mchirlin/camping-escape-room/08-safety-and-compliance/NOTES.md

# Safety — Notes

Project: 2026-camping-minecraft
Created: 2026-04-18
Last updated: 2026-08-25

> **Source of truth:** the authoritative game flow is
> `../02-puzzle-design/flowchart.md`. If anything here disagrees with the
> flowchart, the flowchart wins.

## Assessment — All Clear

- **Stream:** Not deep — ankle-level. Safe for fishing step
- **Allergies:** None in the group
- **Supervision:** Other parents around and available
- **Bathroom/Mine:** Dedicated stall with own exterior door. Only group using the facilities
- **Sword:** Foam only — confirmed
- **TNT / props:** All foam or lightweight props — nothing that can hurt anyone

## Pre-Game Checklist
- [ ] Walk the route for trip hazards, sharp edges, poison ivy
- [ ] Check stream level day-of
- [ ] Confirm bathroom stall is clear and available
- [ ] Test creeper stability — shouldn't fall on a kid, only fall apart when hit
- [ ] Have water/sunscreen available (summer outdoor game)

## No Concerns
- No fog, strobes, or scent effects
- Daytime game — no darkness/visibility issues
- All parents present
- No food allergies to worry about for treats
