mchirlin/camping-escape-room/10-playtesting-and-iteration/NOTES.md

# Playtesting — Notes

Project: 2026-camping-minecraft
Created: 2026-04-18
Last updated: 2026-08-25

> **Source of truth:** the authoritative game flow is
> `../02-puzzle-design/flowchart.md`. If anything here disagrees with the
> flowchart, the flowchart wins.

## Decisions

### Home Testing
- Test crafting table at home — RFID reads, recipe recognition, sound effects, button
- Test all block tags individually and in grid combinations
- Test read range through table surface material

### Playtest Person
- Wife will do a full walkthrough pretending to be a player
- Can't use daughter — would spoil the game

### Campsite Dry Run
- Arrive early on game day
- Hide all blocks, walk the full route
- Test fishing magnet in the actual stream
- Verify creeper placement (stable but falls apart when hit)
- Confirm the locked chest opens cleanly on cue

### Backup Plans (stay flexible)
- RFID reader dies → game master manually confirms recipes (kids place blocks, you check visually, play sound from phone)
- Blocks go missing → have a few spare blocks of each type
- Stream too high → hide the diamonds near the stream bank instead of in the water
- Creeper won't stay up → lean it against a tree
- Weather → crafting table is in tent (covered), outdoor steps still work in light rain

## Pre-Trip Test Checklist
- [ ] Every block tag reads correctly on every grid slot
- [ ] All 10 recipes recognized
- [ ] Wrong recipes correctly rejected
- [ ] Sound plays on success
- [ ] Button works reliably
- [ ] Power bank lasts 2+ hours (enough for two runs)
- [ ] Fishing magnet holds the container
- [ ] Creeper falls apart and re-stacks easily
