mchirlin/camping-escape-room/09-budget-and-timeline/NOTES.md

# Budget & Timeline — Notes

Project: 2026-camping-minecraft
Created: 2026-04-18

## Budget: ~$200

### Breakdown
| Category | Estimate | Notes |
|---|---|---|
| Electronics (PN532 readers, ESP32, multiplexer, NeoPixel rings, speaker, NFC tags, copper tape, wiring) | $120 | Splurge item |
| 3D printing filament | $30 | Blocks + dragon egg |
| Spray paint | $15 | Multiple colors for block types |
| Crafting table wood/materials | $30 | Splurge item |
| Candy/treats | $20 | Finale chest + bonus recipes |
| Cardboard boxes + paint (creeper) | $10 | |
| Misc (magnets, string, parchment) | $15 | |
| **Total** | **~$250** | A bit over $200 — trim misc/treats if needed |

### Already Owned
- 3D printer
- ESP32 or ESP8266
- Maybe an RC522
- Kid-sized garden shovel
- Chests, keys, diary, locks
- Minecraft fox stuffed animal

### Splurge Priority
- Crafting table + blocks — the centerpiece of the whole game

## Timeline: July or August

### Milestones
| When | What |
|---|---|
| May | Order electronics, start 3D printing blocks, design crafting table |
| June | Build crafting table, write Arduino code, test RFID reads at home |
| Early July | Build creeper, make recipe scrolls, paint shovel, prep map |
| Week before trip | Wife playtest, pack everything, prep dig container |
| Day of | Arrive early, hide blocks, set up table in tent, bury chest, go |

### Build Time
- A few hours per week + a few full weekends
- Spread over ~3 months — very doable
