mchirlin/camping-escape-room/05-technology-and-electronics/crafting-table-firmware/dev-preview.html

# ⬜ Crafting Table

Escape Room Control Panel

DEV PREVIEW — mock backend, no hardware connected

Game

Admin

Test

## Slot Status

Touch1: -Touch2: -

## Recipes

Each recipe shows its state. Lock/Unlock to control whether the table will craft it; Craft force-fires it (door + sound + lights) if a piece is lost.

🔄 Reset Game (unlock all)

## Register Tags

Place tag on slot 4 (center), select type, tap Program.

Current: —

💾 Program

## Music

30

## Status

DFPlayer: -

## Log

Connecting...

## LED Tests

💡 Light Test🐛 Pixel Crawl⚫ All Off

## Door Lights

🚪 Door 0🚪 Door 1🚪 Door 2

⚫ Door Lights Off

## Motors

Servo 0Servo 1Servo 2

📳 Vibe ONVibe OFF

0

## Simulate Slots

Tap to toggle LEDs:
