mchirlin/camping-escape-room/04-props-and-materials/sticker-paper.pdf

## paper — Item Stickers (cut along outline)

paper — 1 pixel = 0.2000" — print at 100% on vinyl sticker paper
