mchirlin/camping-escape-room/01-theme-and-narrative/victory-song.md

# Victory Song — "Craft Your Way Home"

Plays at the very end of the event, right after the players blow open the
treasure chest and find the Ender Dragon egg. Triumphant, credits-rolling
finale.

> Story source of truth: `../02-puzzle-design/flowchart.md`. Lyrics follow the
> 10-craft arc (diary → crafting table → compass → pickaxe → map → fishing pole
> → diamond pickaxe → torch → sword → spyglass → TNT → treasure).

- **Audience:** kids ages 7–10, up to 6 players
- **Vibe:** anthemic stadium pop-rock — stomp-clap anthem, big chantable
  "whoa-oh" hooks, quiet-loud dynamics, beat-drop chorus
- **Length:** ~2–3 min
- **Format:** Suno-style (bracketed section/production tags, plain lyric lines)

---

## Lyrics (Suno format)

```
[Intro - sparse stomp-clap, floor toms]

[Verse 1 - low and building]
Woke up with nothin' but a page,
A lost explorer, an empty cage.
No map, no light, no way to know,
Just four little blocks and a will to go.
Laid 'em down, felt the table hum,
Look what we started, look what we've become.

[Pre-Chorus - build the tension]
Oh, we don't need a hero,
We build it on our own,
Piece by piece, brick by brick,
We craft our way back home!

[Chorus - beat drop, full gang vocals]
Whoa-oh-oh! (Craft it!)
Whoa-oh-oh! (Make it!)
Nothin' gonna stop us now, no way!
Whoa-oh-oh! (Build it!)
Whoa-oh-oh! (Take it!)
We're craftin' our way home today!

[Verse 2]
Swung the pickaxe, cracked the stone,
Copper, coal, we're not alone.
Map lit up and the world went wide,
Fished up diamonds from the riverside.
Every block that we ever found,
We saved it up till the time came 'round.

[Pre-Chorus]
Oh, we don't need a hero,
We build it on our own,
Piece by piece, brick by brick,
We craft our way back home!

[Chorus - beat drop, full gang vocals]
Whoa-oh-oh! (Craft it!)
Whoa-oh-oh! (Make it!)
Nothin' gonna stop us now, no way!
Whoa-oh-oh! (Build it!)
Whoa-oh-oh! (Take it!)
We're craftin' our way home today!

[Bridge - drop to a whisper]
Torch in the dark,
Sword in my hand,
The creeper's comin', hold your ground and stand!
Light the fuse,
Three, two, one,

[Breakdown - explode back in]
BOOM!

[Final Chorus - biggest, everyone in]
Whoa-oh-oh! (Craft it!)
Whoa-oh-oh! (Made it!)
Nothin' ever stopped us, no way!
Whoa-oh-oh! (Found it!)
Whoa-oh-oh! (Won it!)
The dragon egg is ours today!
Started with a diary, look how far we've grown,
We crafted, yeah, we crafted, we crafted our way home!

[Outro]
Whoa-oh-oh... craft your way home.
```

---

## Style Prompt (for Suno / Udio / etc.)

```
Anthemic alt-pop / stadium pop-rock. Big stomp-clap
percussion, thick tribal floor-toms, punchy staccato verses that build tension, and
a huge singalong "whoa-oh-oh" gang-vocal chorus with a hard beat drop. Quiet-loud
dynamics: sparse, whispery bridge that explodes into the final chorus. Driving bass,
electronic pulse under organic drums, triumphant and heroic. Clean confident lead
vocal, kid-friendly and easy to chant. Major key, roughly 100–110 BPM. Family-friendly
adventure anthem, credits-rolling energy.
```
