mchirlin/camping-escape-room/06-sound-lighting-atmosphere/event-song.md

# Event Song — "Blocks & Sunshine"

A second, companion song to the finale victory song (`victory-song.md`). Where
that one narrates the 10-craft adventure, this one is about the *feeling* of the
whole event — friendship and the "best day ever" rush — wrapped in the Minecraft
world (blocks, crafting, mining, biomes, mobs, day and night). It leans on the
vibe of the game, not the specific escape-room items and locations, with just a
sprinkle of specifics (a creeper, a diamond). Bright, glossy, radio-pop.

> Story source of truth: `../02-puzzle-design/flowchart.md`. This song is
> intentionally non-literal (no step-by-step crafts or real-world locations), so
> it stays evergreen even if game details shift — it just needs to stay true to
> the Minecraft spirit and the fun/teamwork of the day.

- **Audience:** kids ages 7–10, up to 6 players
- **Vibe:** feel-good modern radio pop — claps, big "oh-oh-oh" hooks,
  key-change final chorus — with a Minecraft heart
- **Length:** ~2–3 min
- **Format:** Suno-style (bracketed section/production tags, plain lyric lines)

---

## Lyrics (Suno format)

```
[Intro - claps and finger-snaps]

[Verse 1 - light and bouncy]
Sun comes up on a world of squares,
Grass and stone and sky everywhere.
We spawned in with empty hands,
Just a heartbeat and a dream and a plan.
Punch a tree, watch the whole world start,
Everything you build, you build it from the heart.

[Pre-Chorus - lift]
And oh, the day is shinin',
Oh, the world is ours,
Block by block, side by side,
We're stackin' up the hours!

[Chorus - huge and glossy]
This is our world, our world,
Craftin' wild and free!
Oh-oh-oh, we'll remember,
Just you and me!
'Fore the night comes down we'll build it up high,
Diamonds in our pockets, hands in the sky,
This is our world, our world,
The best day ever!

[Verse 2]
Dig a little deeper, chase the shine,
Every little block feels a mile high.
Nobody's alone when we mine it all together,
Come on, build it up, we could go on forever.
Take a little screenshot in the back of my mind,
Freeze this perfect square in time.

[Pre-Chorus - lift]
And oh, the day is shinin',
Oh, the world is ours,
Block by block, side by side,
We're stackin' up the hours!

[Chorus - huge and glossy]
This is our world, our world,
Craftin' wild and free!
Oh-oh-oh, we'll remember,
Just you and me!
'Fore the night comes down we'll build it up high,
Diamonds in our pockets, hands in the sky,
This is our world, our world,
The best day ever!

[Bridge - strip back to vocals and claps]
Sun goes down and the sky turns gray,
Hear a little hiss, don't run away!
Creeper's comin' closer, (uh-oh!)
We stand together and we save the day!

[Final Chorus - key change, everyone singing]
This is our world, our world,
Craftin' wild and free!
Oh-oh-oh, we'll remember,
You and me!
When the sun comes back we'll say we were there,
Best friends, best blocks, everywhere,
This is our world, our world,
The best day ever!

[Outro]
Oh-oh-oh... the best day ever.
```

---

## Style Prompt (for Suno / Udio / etc.)

```
Bright, glossy modern feel-good radio pop. Punchy four-on-the-floor beat, hand-claps and finger-snaps, shimmering synths,
bouncy plucked bass, and a massive, sticky singalong chorus with "oh-oh-oh" hooks. Add
subtle 8-bit / chiptune sparkles as a playful nod to Minecraft. Sunny major key, polished
and euphoric, adventurous "best day ever" feeling. Layered stacked vocals, a stripped-back
bridge that builds into a key-change final chorus. Clean, youthful lead vocal, super
kid-friendly and easy to sing. Upbeat, around 118–124 BPM.
```
