mchirlin/camping-escape-room/04-props-and-materials/NOTES.md

# Props & Materials — Notes

Project: 2026-camping-minecraft
Created: 2026-04-18
Last updated: 2026-08-25

> **Source of truth:** the authoritative game flow (crafts, props, ingredients)
> is `../02-puzzle-design/flowchart.md`. If anything here disagrees with the
> flowchart, the flowchart wins.

## Decisions

### 3D-Printed Blocks & Items
- **Two shapes** to match Minecraft's block vs item distinction:
  - **Blocks** (Wood Plank): 3" × 3" × 3" full cubes — 4 total
  - **Items** (everything else): 3" × 3" × 1.5" flat slabs — 30 total
- Same 3×3" footprint so both fit the crafting table grid slots
- Flat items use less filament and print faster (~half the volume)
- Kids can tell blocks from items by feel, just like in Minecraft
- Black PLA base
- **Printable vinyl sticker paper** for textures — actual Minecraft block/item textures printed on matte waterproof vinyl sheets
- Blocks: texture on all 6 faces (cut to 3" squares)
- Items: item texture centered on top face, plain/dark sides (top: 3"×3", sides: 3"×1.5")
- Clear coat matte spray over stickers to prevent edge peeling
- Bottom face can be left bare (sits on reader, nobody sees it)
- NTAG215 coin tags embedded mid-print (cavity near bottom, pause at layer, drop in, resume)
- NFC tag is closer to the reader in flat items (1.5" vs 3") — better read reliability
- Block type written to tag data (Option B)
- Registration program on ESP32 to write block types to tags

#### Magnetic Snap-Together Option
- 3D print cubes with internal compartments at each of the 8 corners
- Drop a 5mm magnetic ball bearing into each corner compartment (8 magnets per block)
- Sphere magnets self-align polarity — blocks always attract regardless of orientation
- Dab glue on the cap to prevent strong neighbors from pulling balls out
- Avoids the fixed-polarity problem of flat/cube magnets
- Players can freely stack and arrange blocks without "wrong" orientations
- Magnet count estimate: 8 per block × number of blocks needed
- Source: [Instructables - Fay3dlab](https://www.instructables.com/Magnetic-Blocks-AKA-Minecraft-Blocks/)

### Crafting Table
- Small nightstand-sized, but shorter (kid height)
- Flat surface with lip creating recessed 3x3 grid on top
- Wood construction
- Splurge item — worth spending time and money on

### Physical Props Dispensed by Crafts

The 10 crafts (see `flowchart.md`). Eight dispense a physical prop through one of
the 3 crafting-table doors; the Crafting Table craft is the tutorial and the Map
lights up the iPad, so neither needs a prop.

1. Crafting Table — tutorial craft, no prop (unlocks the tent)
2. Compass — MCompass (real working Minecraft compass, from Etsy)
3. Cobblestone Pickaxe — prop (plywood/3D-printed cutout)
4. Map — fog-of-war app on iPad/phone (digital, no physical prop)
5. Fishing Pole — real stick + string + magnet
6. Diamond Pickaxe — prop (plywood/3D-printed cutout)
7. Torch — prop
8. Iron Sword — foam sword
9. Spyglass — prop (spyglass cutout / tube)
10. TNT — prop (used to "open" the locked treasure chest)

> Legacy note: earlier drafts listed a Wooden Pickaxe, Gold Sword, and Diamond
> Shovel. Those are not in the current design — the pickaxes are
> cobblestone/diamond, the blade is an iron sword, and there is no shovel.

### Creeper
- 4 cardboard boxes stacked to adult height, painted creeper green
- Iconic face on top box
- Pre-scored tape so it falls apart on hit
- Loot inside head box

### Ender Dragon Egg
- 3D printed, painted — keepsake quality
- Placed inside the locked treasure chest with candy/treats (opened by the TNT craft)

### Other Props Already Owned
- Chests
- Keys
- Diary (potential intro prop — explorer's journal)
- Minecraft fox stuffed animal (holds a hint)
- Locks

### Still Need to Source
- RFID tags (NFC stickers compatible with RC522/PN532)
- Spray paint (multiple colors for block types)
- Cardboard boxes for creeper
- Foam sword (check friends first, Amazon backup)
- Magnets for fishing rod
- Parchment paper for recipe scrolls and map
- Candy/treats
- Wood for crafting table build

## Open Questions
- Exact NFC sticker model that works embedded in PLA at 3cm read distance
- Foam sword — friends have one or need to buy?
- Block color scheme per type (match Minecraft textures)
