mchirlin/camping-escape-room/04-props-and-materials/INVENTORY.md

# Prop Inventory

**Project:** 2026-camping-minecraft  
**Updated:** 2026-08-19

---

## Crafting Blocks (3D printed cubes with NFC tags)

| Item | Qty | Notes |
|---|-----|---|
| Gold Ingot | 3 | |
| Iron Ingot | 6 | |
| Redstone | 1 | |
| Emerald | 1 | For villager trading |
| Paper | 8 | For map recipe |
| Tripwire | 1 | |
| Coal | 2 | |
| Gunpowder | 5 | |
| Diamond | 3 | |
| Oak Plank | 4 | For crafting table recipe |
| Sand | 4 | |
| Cobblestone | 3 | |
| Stick | 11 | |
| String | 3 | |
| Compass Block | 1 | Points north (for map recipe?) |
| Amethyst Shard | 1 | |
| Copper Ingot | 2 | |

**Total blocks:** 59

---

## Finished Props (tools/items to be earned)

| Item | Qty | Notes |
|---|-----|---|
| Cobblestone Pickaxe | 1 | |
| Diamond Pickaxe | 1 | |
| Fishing Pole | 1 | |
| Torch | 1 | |
| Map | 1 | iPad/device |
| Compass | 1 | Physical prop (points north) |
| Iron Sword | 1 | |
| Spyglass | 1 | |
| Bow | 1 | |
| Crossbow | 1 | |
| Minecraft Fox | 1 | Stuffed animal / plush |
| Unpainted Sword | 1 | Spare/extra |
| Unpainted Pickaxe | 1 | Spare/extra |

**Total finished props:** 13

---

## Major Equipment

| Item | Qty | Notes |
|---|-----|---|
| Crafting Table | 1 | ESP32-powered, 3×3 NFC grid |
| Fog of War Map | 1 | iPad/device app |

---

## Still Needed

*To be determined based on final flow*

---

## Notes

- Compass block vs compass prop: block is for crafting into map, prop is the reward
