mchirlin/camping-escape-room/04-props-and-materials/sticker-block-oak_planks-8.pdf

### oak_planks — 8 block faces (print at 100%)

oak_planks — 8 faces (2.5" each) — print at 100% on vinyl sticker paper
