mchirlin/camping-escape-room/04-props-and-materials/sticker-emerald.pdf

## emerald — Item Stickers (cut along outline)

emerald — 1 pixel = 0.2500" — print at 100% on vinyl sticker paper
