mchirlin/camping-escape-room/04-props-and-materials/sticker-tripwire_hook.pdf

## tripwire_hook — Item Stickers (cut along outline)

tripwire_hook — 1 pixel = 0.2308" — print at 100% on vinyl sticker paper
