mchirlin/camping-escape-room/04-props-and-materials/sticker-amethyst_shard.pdf

## amethyst_shard — Item Stickers (cut along outline)

amethyst_shard — 1 pixel = 0.2308" — print at 100% on vinyl sticker paper
