mchirlin/camping-escape-room/04-props-and-materials/sticker-coal.pdf

## coal — Item Stickers (cut along outline)

coal — 1 pixel = 0.2308" — print at 100% on vinyl sticker paper
