mchirlin/camping-escape-room/04-props-and-materials/sticker-copper_ingot.pdf

## copper_ingot — Item Stickers (cut along outline)

copper_ingot — 1 pixel = 0.1875" — print at 100% on vinyl sticker paper
