mchirlin/camping-escape-room/04-props-and-materials/sticker-gold_ingot.pdf

## gold_ingot — Item Stickers (cut along outline)

gold_ingot — 1 pixel = 0.1875" — print at 100% on vinyl sticker paper
