mchirlin/camping-escape-room/04-props-and-materials/sticker-gunpowder.pdf

## gunpowder — Item Stickers (cut along outline)

gunpowder — 1 pixel = 0.2500" — print at 100% on vinyl sticker paper
