mchirlin/camping-escape-room/04-props-and-materials/sticker-iron_ingot.pdf

## iron_ingot — Item Stickers (cut along outline)

iron_ingot — 1 pixel = 0.1875" — print at 100% on vinyl sticker paper
