mchirlin/camping-escape-room/04-props-and-materials/sticker-stick-original.pdf

## stick-original — Item Stickers (cut along outline)

stick-original — 1 pixel = 0.2308" — print at 100% on vinyl sticker paper
