mchirlin/camping-escape-room/04-props-and-materials/sticker-stick.pdf

## stick — Item Stickers (cut along outline)

stick — 1 pixel = 0.2308" — print at 100% on vinyl sticker paper
