mchirlin/camping-escape-room/04-props-and-materials/sticker-string.pdf

## string — Item Stickers (cut along outline)

string — 1 pixel = 0.2143" — print at 100% on vinyl sticker paper
