mchirlin/camping-escape-room/04-props-and-materials/sticker-diamond.pdf

## diamond — Item Stickers (cut along outline)

diamond — 1 pixel = 0.2308" — print at 100% on vinyl sticker paper
