mchirlin/camping-escape-room/04-props-and-materials/sticker-redstone.pdf

## redstone — Item Stickers (cut along outline)

redstone — 1 pixel = 0.2500" — print at 100% on vinyl sticker paper
