mchirlin/camping-escape-room/04-props-and-materials/stencils-all.pdf

# Prop Reference Sheet

1 pixel = 1.094" at full scale

Gold Sword

Wooden Pickaxe

Fishing Rod

Sword [1,2]

Sword [1,3]

Sword — 1 sq = 1.094"

Sword [1,4]

Sword [2,1]

Sword — 1 sq = 1.094"

Sword [2,2]

Sword [2,3]

Sword — 1 sq = 1.094"

Sword [2,4]

Sword [3,1]

Sword — 1 sq = 1.094"

Sword [3,2]

Pickaxe [1,1]

Pickaxe + Sword — 1 sq = 1.094"

Pickaxe [1,3]

Pickaxe [1,4]

Pickaxe — 1 sq = 1.094"

Pickaxe [2,1]

Pickaxe [2,2]

Pickaxe — 1 sq = 1.094"

Pickaxe [2,3]

Pickaxe [3,1]

Pickaxe — 1 sq = 1.094"

Pickaxe [3,2]

Pickaxe [3,3]

Pickaxe — 1 sq = 1.094"

Rod [1,3]

Rod [1,4]

Rod — 1 sq = 1.094"

Rod [2,1]

Rod [2,2]

Rod — 1 sq = 1.094"

Rod [2,3]

Rod [2,4]

Rod — 1 sq = 1.094"

Rod [3,1]

Rod [3,2]

Rod — 1 sq = 1.094"

Rod [3,3]

Rod [3,4]

Rod — 1 sq = 1.094"
