mchirlin/camping-escape-room/04-props-and-materials/sticker-tnt.pdf

TNT | Side | TNT | Side | TNT Side
TNT Side | TNT Top
