mchirlin/camping-escape-room/04-props-and-materials/sticker-combo-extras.pdf

Mixed: 2 Coal, 2 Copper Ingot, 1 Amethyst Shard
