mchirlin/camping-escape-room/04-props-and-materials/3d models/3mf Servo 9g flatmount bracket V2.3mf

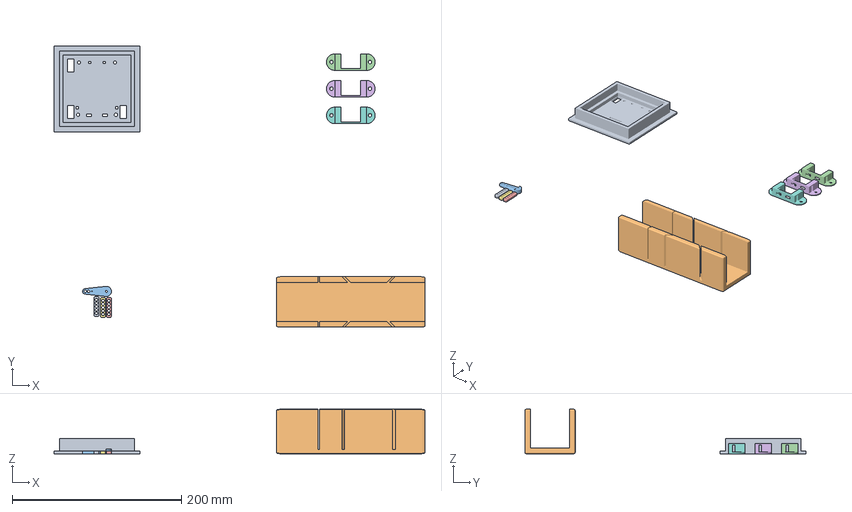
[picture p1: CAD file, 2026-08-13]
04-props-and-materials/3d models/3mf Servo 9g flatmount bracket V2.3mf
438.5 x 332.6 x 52.6 mm
daughterholder.stl
Saw Guide.stl
3mf Servo 9g flatmount bracket V2.stl x 3
Body1.stl x 3
