mchirlin/camping-escape-room/04-props-and-materials/bambu-project.3mf

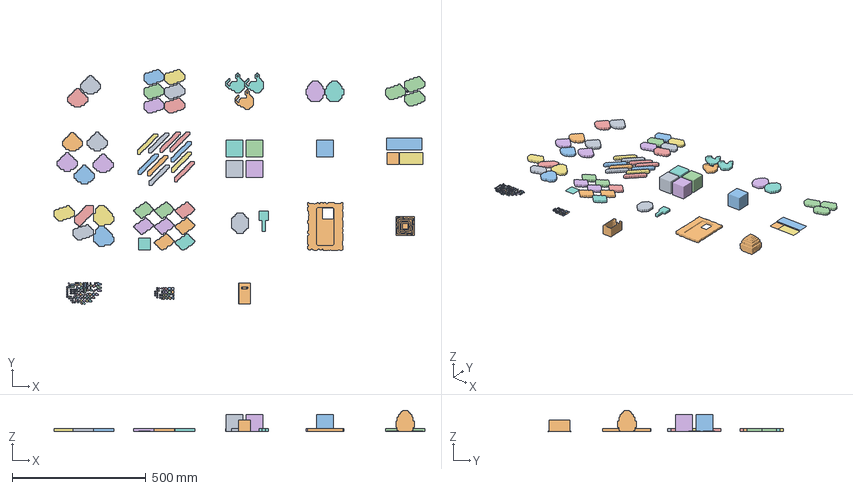
[picture p2: CAD file, 2026-08-28]
04-props-and-materials/bambu-project.3mf
1386.6 x 879.7 x 80.0 mm
redstone-item.stl x 2
NEGRO.stl
minecraft-block.stl x 5
paper-item.stl x 8
coal-item.stl x 2
amethyst_shard-item.stl
copper_ingot-item.stl x 2
3 pixel.stl
stick-double-wide-item.stl x 10
2 pixel.stl
1 pixel.stl x 2
gunpowder-item.stl x 5
gold_ingot-item.stl x 3
diamond-item.stl x 2
string-item.stl x 3
iron_ingot-item.stl x 6
Text
tripwire_hook-item.stl
emerald-item.stl
minecraft-map-case-iphone15pro.stl
GRIS.stl_9
GRIS.stl_60
GRIS.stl_26
GRIS.stl_43
GRIS.stl_23
GRIS.stl_57
GRIS.stl_6
GRIS.stl_40
GRIS.stl_2
GRIS.stl_53
GRIS.stl_19
GRIS.stl_36
GRIS.stl_59
GRIS.stl_4
GRIS.stl_25
GRIS.stl_66
GRIS.stl_8
GRIS.stl_28
GRIS.stl_69
GRIS.stl_11
GRIS.stl_32
GRIS.stl_70
GRIS.stl_38
GRIS.stl_15
GRIS.stl_42
GRIS.stl_45
GRIS.stl_49
GRIS.stl_62
GRIS.stl_21
GRIS.stl_55
GRIS.stl_12
GRIS.stl_29
GRIS.stl_46
GRIS.stl_63
GRIS.stl_48
GRIS.stl_24
GRIS.stl_7
GRIS.stl_35
GRIS.stl_13
GRIS.stl_14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
