mchirlin/camping-escape-room/04-props-and-materials/3d models/MiniServoBracket_v2.stl

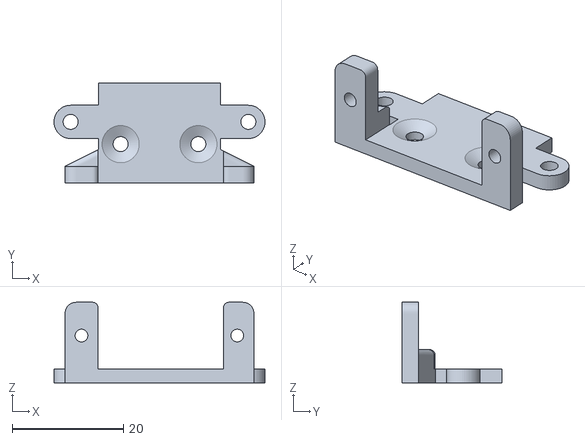
[picture p3: CAD file, 2026-04-28]
04-props-and-materials/3d models/MiniServoBracket_v2.stl
38.0 x 18.0 x 14.5
