mchirlin/camping-escape-room/04-props-and-materials/minecraft-map-case-iphone15pro.stl

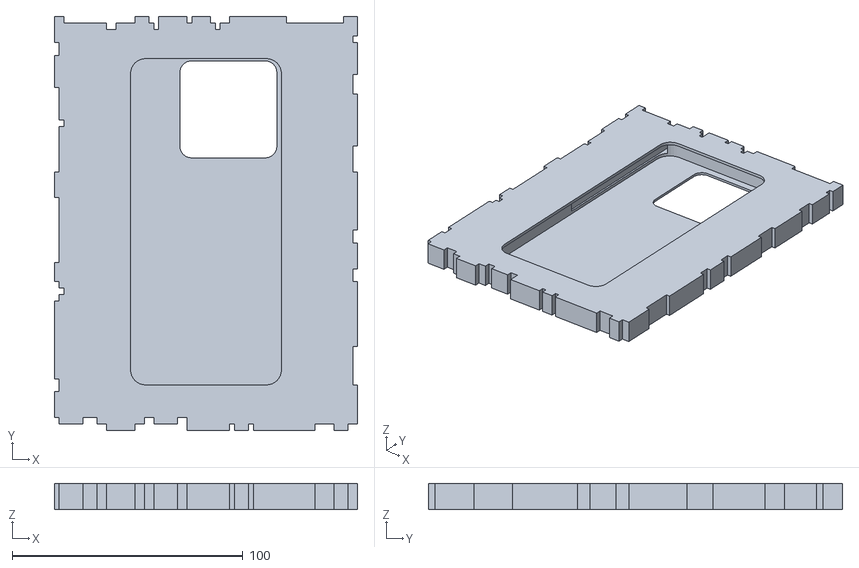
[picture p4: CAD file, 2026-08-25]
04-props-and-materials/minecraft-map-case-iphone15pro.stl
131.4 x 179.4 x 11.4
