mchirlin/camping-escape-room/04-props-and-materials/minecraft-map-case-iphone5s.stl

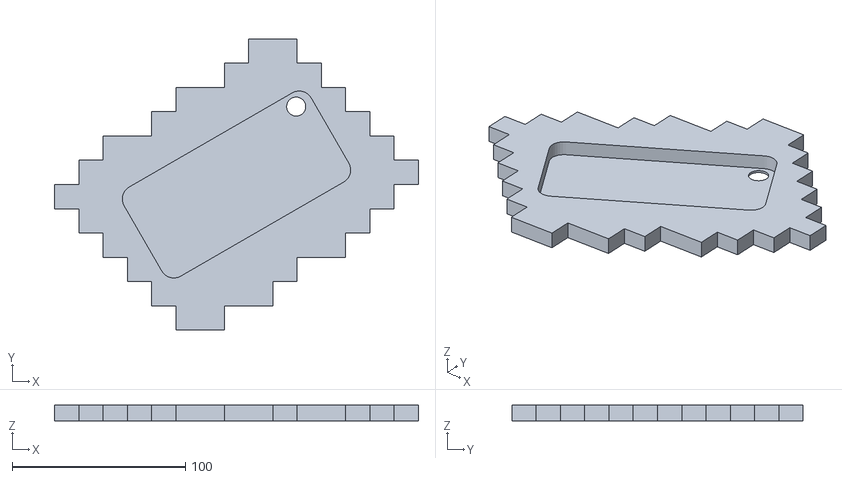
[picture p5: CAD file, 2026-08-23]
04-props-and-materials/minecraft-map-case-iphone5s.stl
210.0 x 168.0 x 9.20
