mchirlin/camping-escape-room/04-props-and-materials/tripwire_hook-item.stl

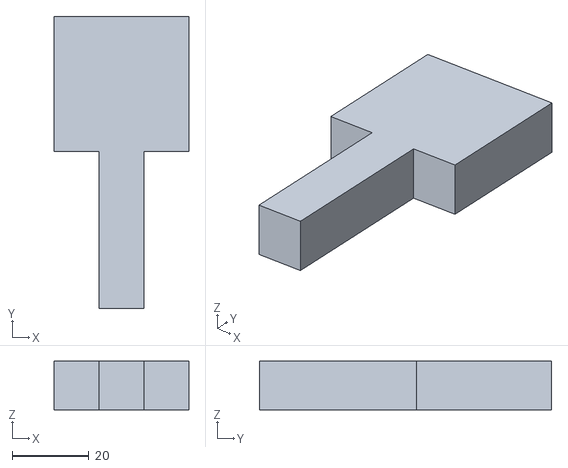
[picture p6: CAD file, 2026-08-18]
04-props-and-materials/tripwire_hook-item.stl
35.2 x 76.2 x 12.7
