mchirlin/camping-escape-room/04-props-and-materials/emerald-item.stl

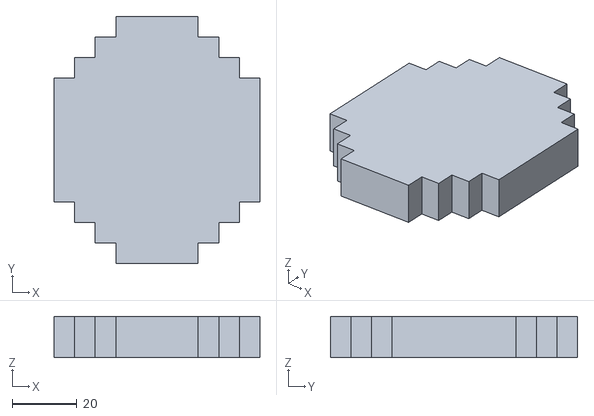
[picture p7: CAD file, 2026-08-16]
04-props-and-materials/emerald-item.stl
63.5 x 76.2 x 12.7
