mchirlin/camping-escape-room/04-props-and-materials/minecraft-block.stl

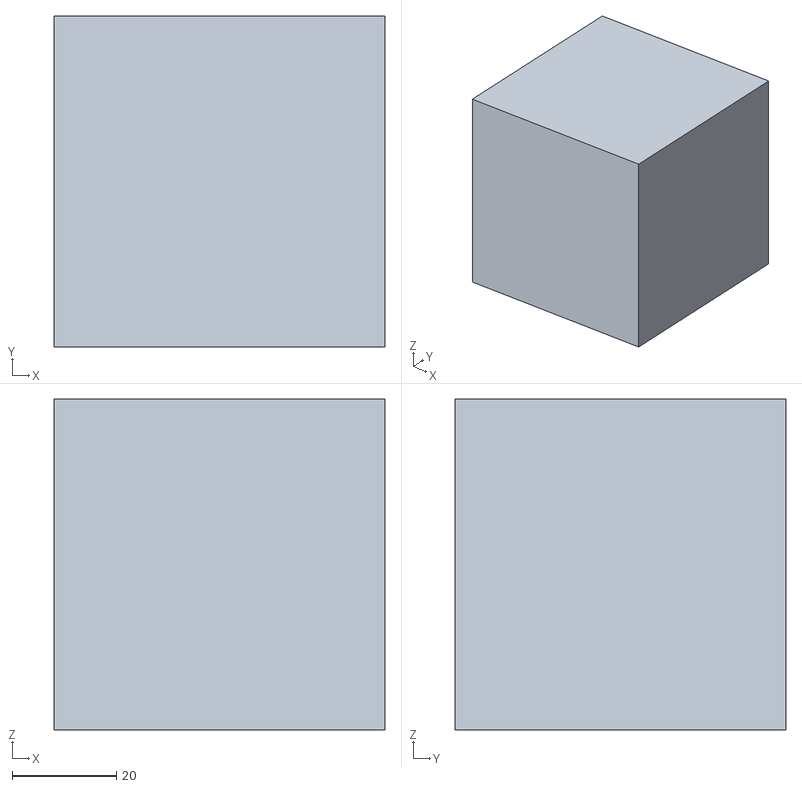
[picture p8: CAD file, 2026-08-16]
04-props-and-materials/minecraft-block.stl
63.5 x 63.5 x 63.5
