mchirlin/camping-escape-room/04-props-and-materials/paint-stencils.stl

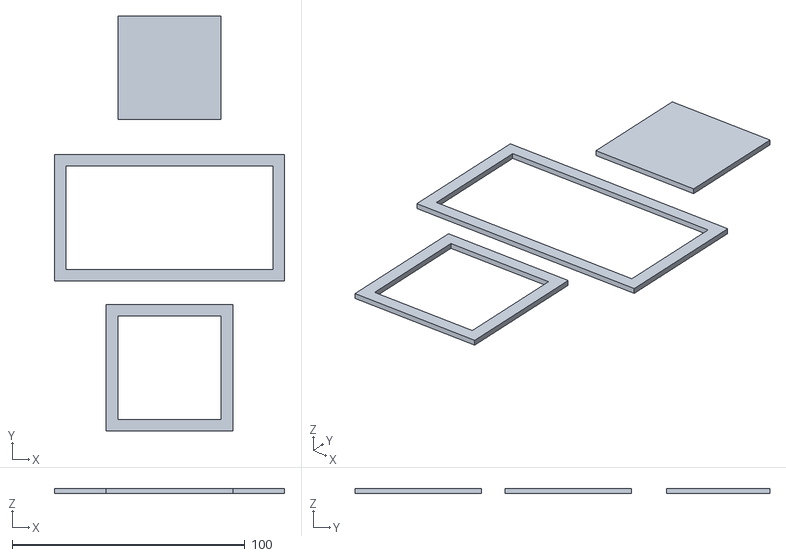
[picture p9: CAD file, 2026-08-16]
04-props-and-materials/paint-stencils.stl
98.9 x 178.3 x 2.00
