mchirlin/camping-escape-room/04-props-and-materials/1 pixel stencil.stl

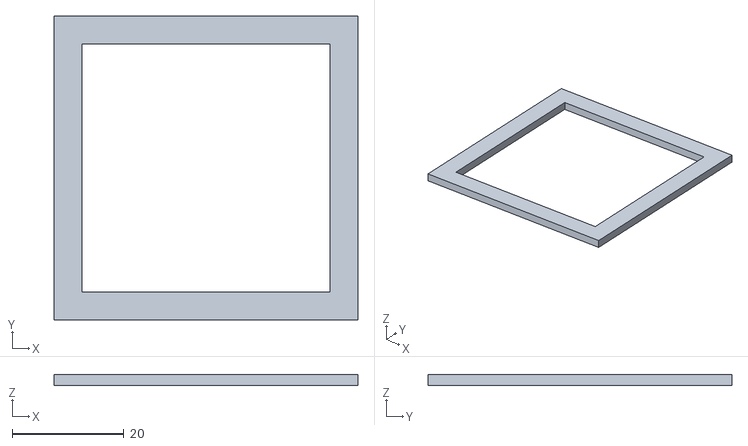
[picture p10: CAD file, 2026-08-16]
04-props-and-materials/1 pixel stencil.stl
54.4 x 54.4 x 2.00
