mchirlin/camping-escape-room/04-props-and-materials/amethyst_shard-item.stl

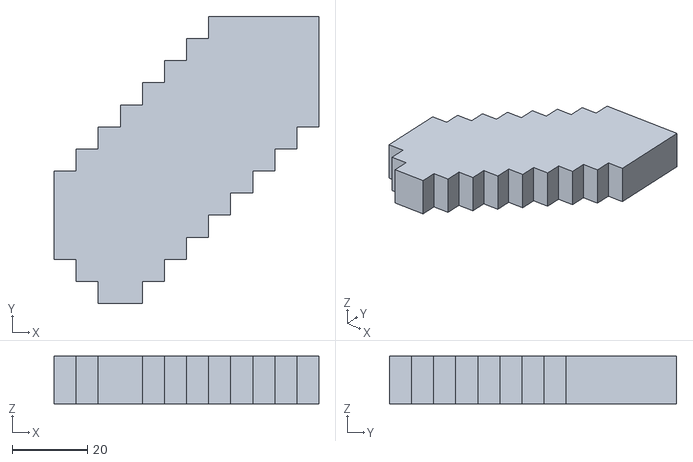
[picture p11: CAD file, 2026-08-16]
04-props-and-materials/amethyst_shard-item.stl
70.3 x 76.2 x 12.7
