mchirlin/camping-escape-room/04-props-and-materials/paper-item.stl

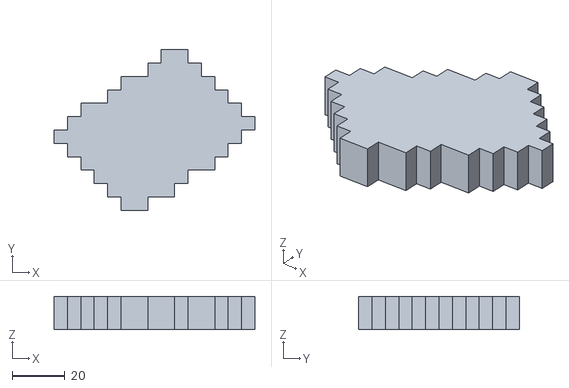
[picture p12: CAD file, 2026-08-16]
04-props-and-materials/paper-item.stl
76.2 x 61.0 x 12.7
