mchirlin/camping-escape-room/04-props-and-materials/3 pixel.stl

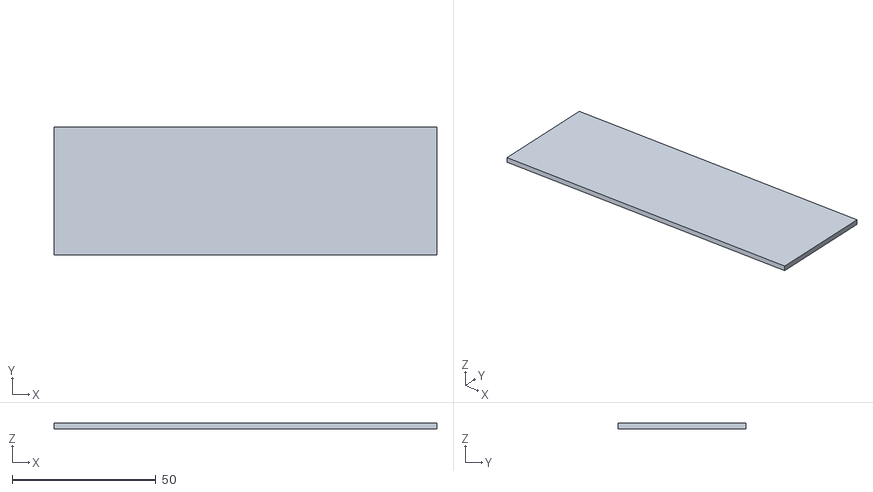
[picture p13: CAD file, 2026-08-16]
04-props-and-materials/3 pixel.stl
133.4 x 44.4 x 2.00
