mchirlin/camping-escape-room/04-props-and-materials/1 pixel.stl

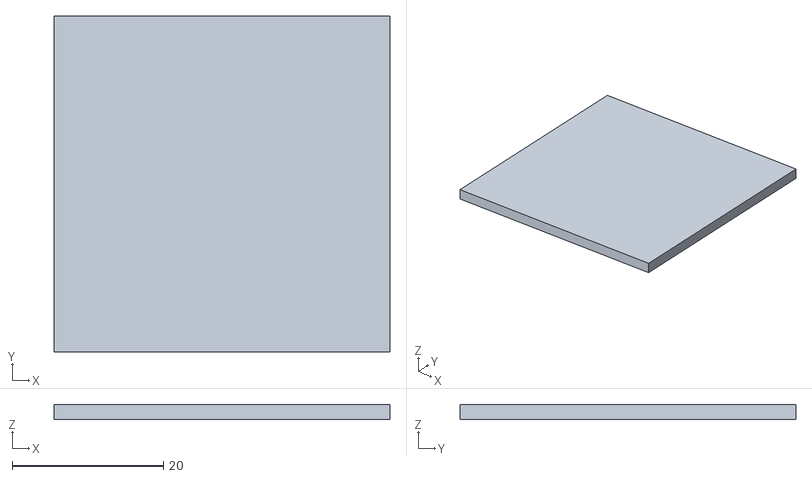
[picture p14: CAD file, 2026-08-16]
04-props-and-materials/1 pixel.stl
44.5 x 44.4 x 2.00
