mchirlin/camping-escape-room/04-props-and-materials/coal-item.stl

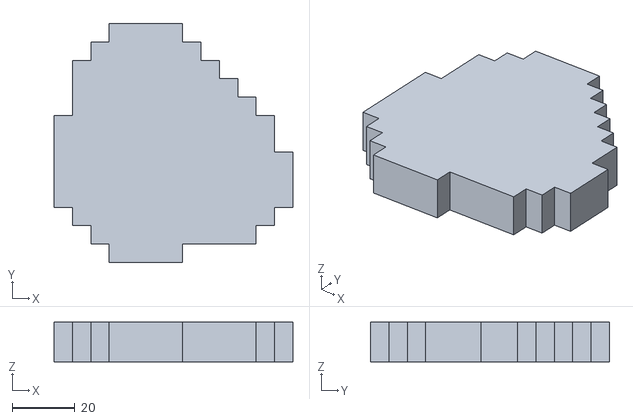
[picture p15: CAD file, 2026-08-16]
04-props-and-materials/coal-item.stl
76.2 x 76.2 x 12.7
