mchirlin/camping-escape-room/04-props-and-materials/2 pixel stencil.stl

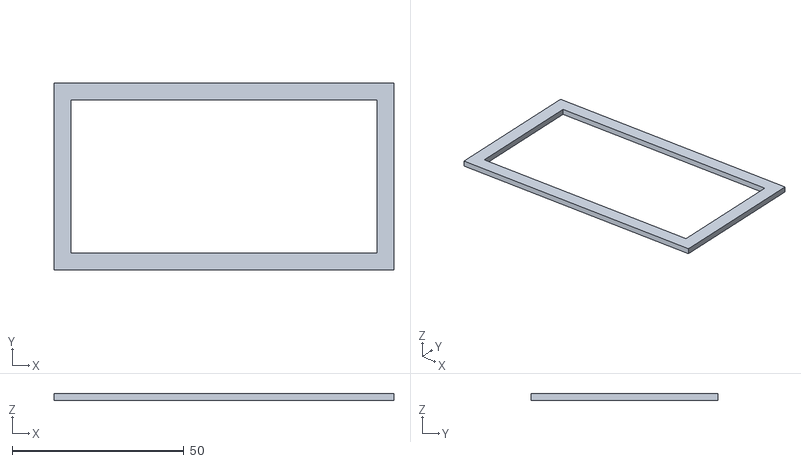
[picture p16: CAD file, 2026-08-16]
04-props-and-materials/2 pixel stencil.stl
98.9 x 54.5 x 2.00
