mchirlin/camping-escape-room/04-props-and-materials/2 pixel.stl

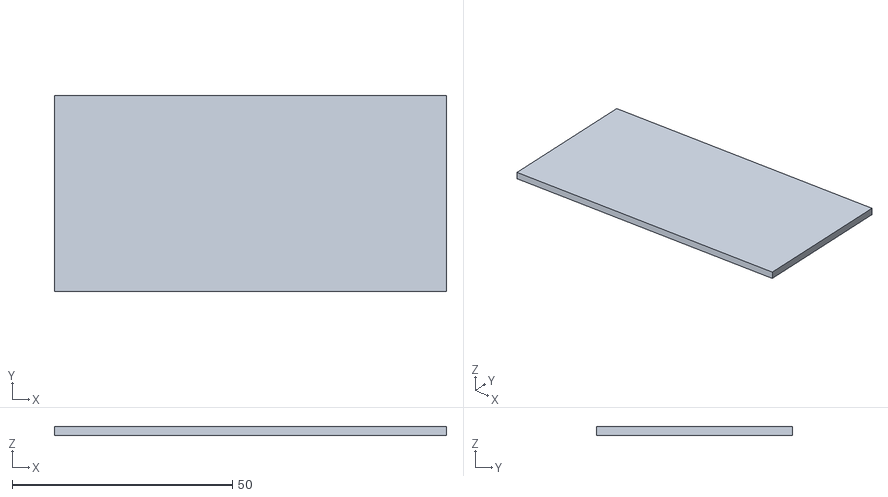
[picture p17: CAD file, 2026-08-16]
04-props-and-materials/2 pixel.stl
88.9 x 44.4 x 2.00
