mchirlin/camping-escape-room/04-props-and-materials/gunpowder-item.stl

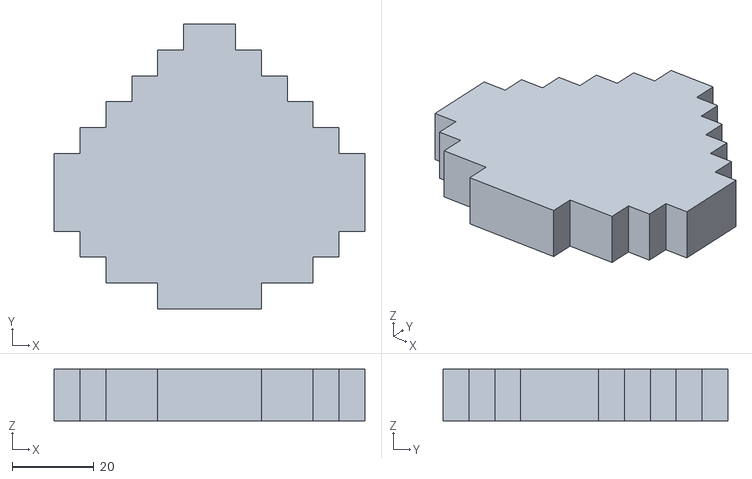
[picture p18: CAD file, 2026-08-13]
04-props-and-materials/gunpowder-item.stl
76.2 x 69.9 x 12.7
