mchirlin/camping-escape-room/04-props-and-materials/string-item.stl

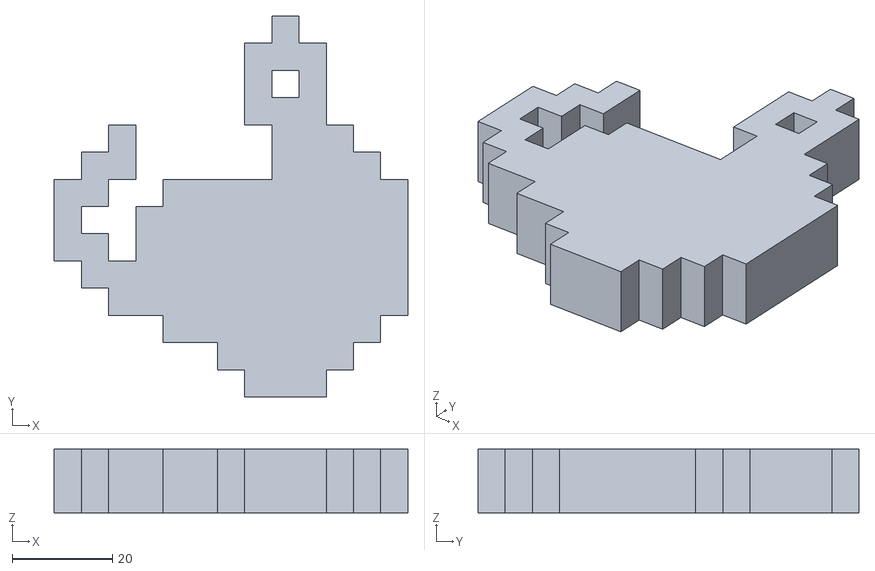
[picture p19: CAD file, 2026-08-13]
04-props-and-materials/string-item.stl
70.8 x 76.2 x 12.7
