mchirlin/camping-escape-room/04-props-and-materials/copper_ingot-item.stl

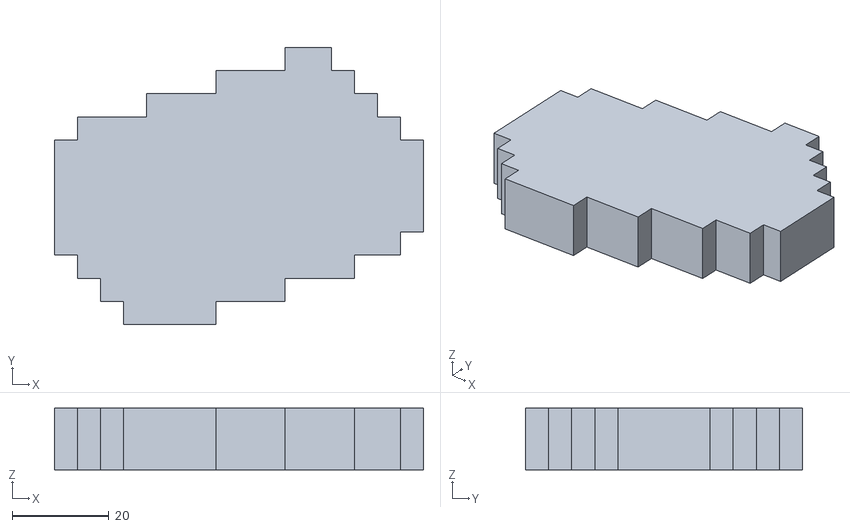
[picture p20: CAD file, 2026-08-13]
04-props-and-materials/copper_ingot-item.stl
76.2 x 57.2 x 12.7
