mchirlin/camping-escape-room/04-props-and-materials/stick-double-wide-item.3mf

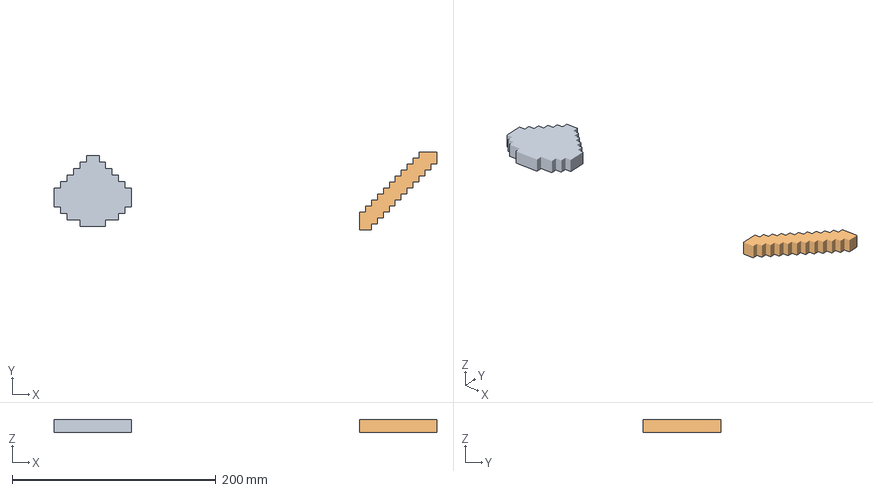
[picture p21: CAD file, 2026-08-13]
04-props-and-materials/stick-double-wide-item.3mf
376.2 x 76.2 x 12.7 mm
redstone-item.stl
stick-double-wide-item.stl
