mchirlin/camping-escape-room/04-props-and-materials/diamond-item.stl

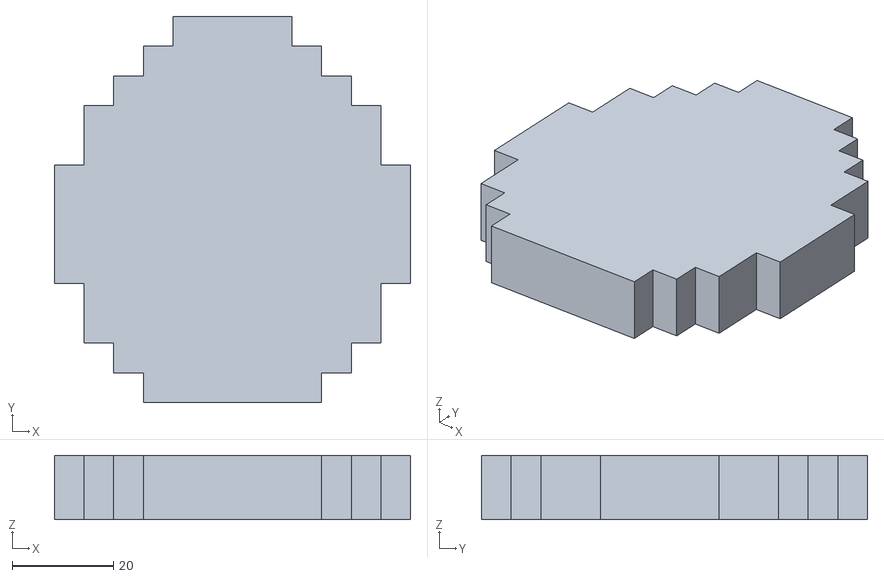
[picture p22: CAD file, 2026-08-13]
04-props-and-materials/diamond-item.stl
70.3 x 76.2 x 12.7
