mchirlin/camping-escape-room/(list of files, cad)

Other CAD files:
04-props-and-materials/redstone-item.stl
04-props-and-materials/copper_ingot-item.scad
04-props-and-materials/diamond-item.scad
04-props-and-materials/emerald-item.scad
04-props-and-materials/gold_ingot-item.scad
04-props-and-materials/iron_ingot-item.scad
04-props-and-materials/paper-item.scad
04-props-and-materials/redstone-item.scad
04-props-and-materials/stick-item.scad
04-props-and-materials/string-item.scad
04-props-and-materials/tripwire_hook-item.scad
04-props-and-materials/Crafting table.skp
04-props-and-materials/Crafting table~.skp
04-props-and-materials/stick-double-wide-item.stl
