mchirlin/camping-escape-room/04-props-and-materials/print-sheet-combined.pdf

Print Sheet — emerald + tripwire_hook + oak_planks (print at 100%)

Page 1 — 1× emerald, 1× tripwire_hook, 6× oak_planks face oak_planks block faces — page 2

Page 2 — 12× oak_planks face oak_planks block faces — page 3

Page 3 — 2× oak_planks face
