mchirlin/camping-escape-room/04-props-and-materials/speaker-hole-pattern.pdf

# Speaker Hole Drill Pattern

### 1.5" diameter • 3mm holes • Print at 100% scale

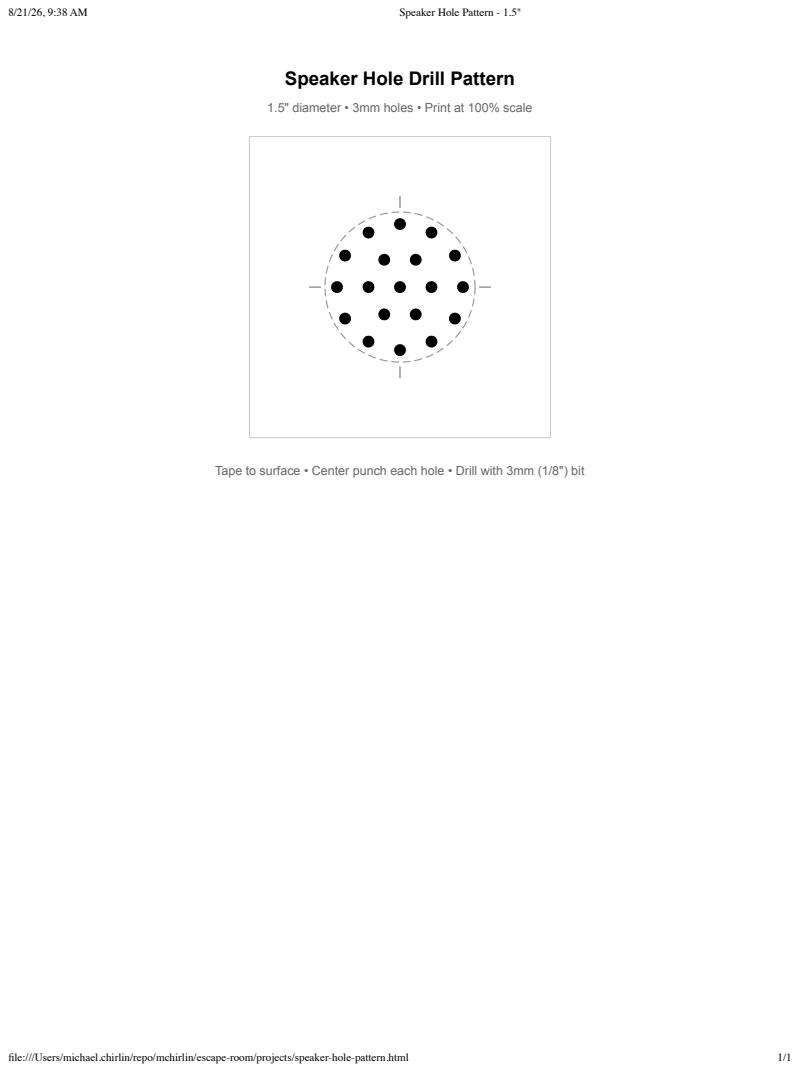
[picture p24: page 1]
Speaker Hole Pattern - 1.5"; file:///Users/michael.chirlin/repo/mchirlin/escape-room/projects/speaker-hole-pattern.html

Tape to surface • Center punch each hole • Drill with 3mm (1/8") bit
