mchirlin/camping-escape-room/05-technology-and-electronics/kicad/crafting-table/motherboard/motherboard.kicad_pcb

## KiCad design 05-technology-and-electronics/kicad/crafting-table/motherboard/motherboard.kicad_pcb (2026-08-13)

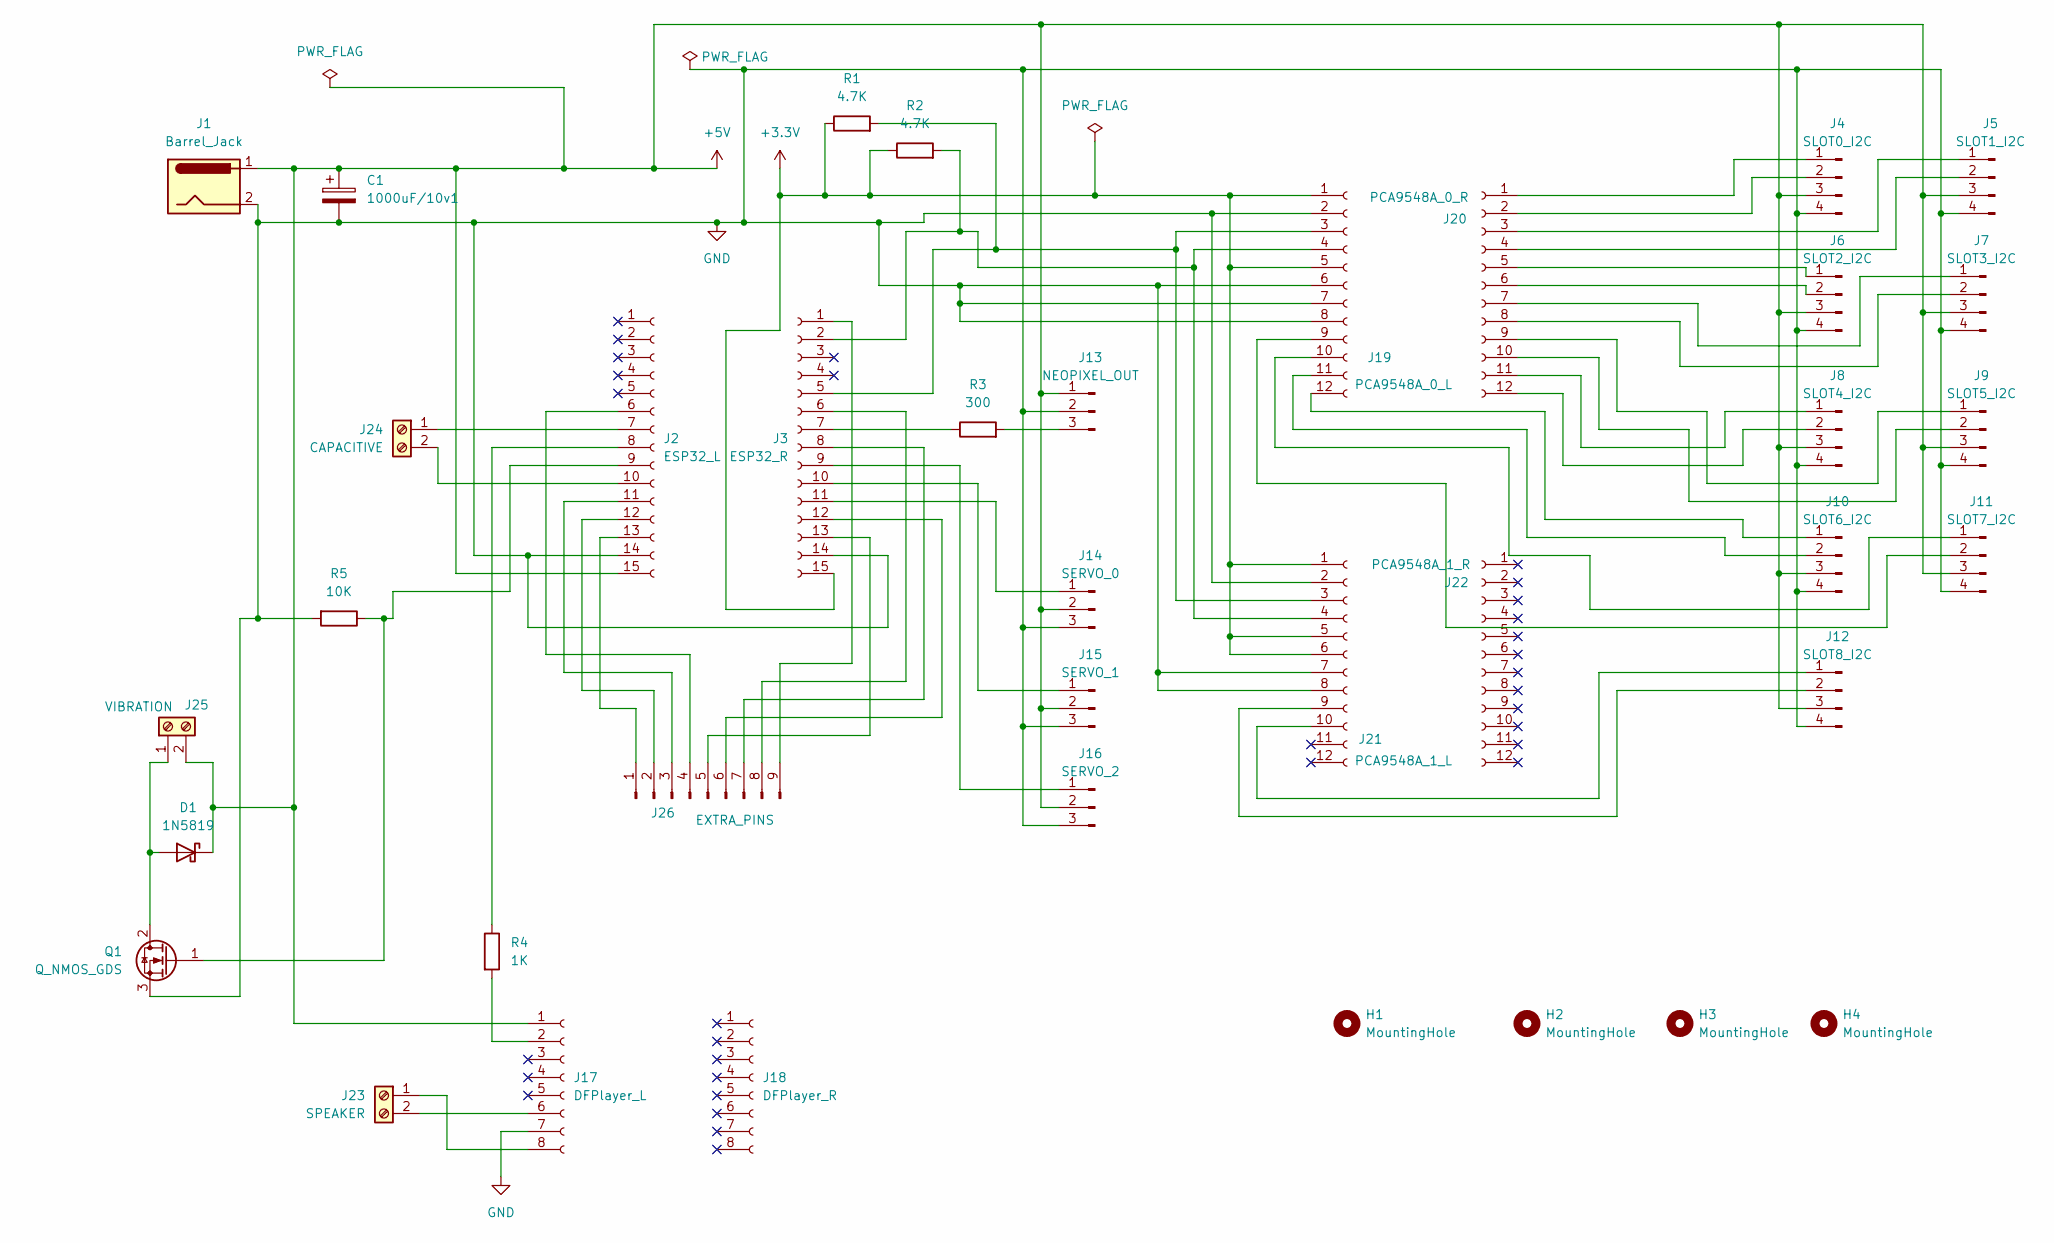
[picture p25: schematic motherboard.kicad_sch]

Parts:
C1: 1000uF/10v1; CP_Radial_D10.0mm_P5.00mm
D1: 1N5819; D_DO-41_SOD81_P10.16mm_Horizontal
H1, H2, H3, H4: MountingHole; MountingHole_3.2mm_M3
J1: Barrel_Jack; BarrelJack_Horizontal
J2: ESP32_L; PinSocket_1x15_P2.54mm_Vertical
J3: ESP32_R; PinSocket_1x15_P2.54mm_Vertical
J4: SLOT0_I2C; JST_XH_B4B-XH-A_1x04_P2.50mm_Vertical
J5: SLOT1_I2C; JST_XH_B4B-XH-A_1x04_P2.50mm_Vertical
J6: SLOT2_I2C; JST_XH_B4B-XH-A_1x04_P2.50mm_Vertical
J7: SLOT3_I2C; JST_XH_B4B-XH-A_1x04_P2.50mm_Vertical
J8: SLOT4_I2C; JST_XH_B4B-XH-A_1x04_P2.50mm_Vertical
J9: SLOT5_I2C; JST_XH_B4B-XH-A_1x04_P2.50mm_Vertical
J10: SLOT6_I2C; JST_XH_B4B-XH-A_1x04_P2.50mm_Vertical
J11: SLOT7_I2C; JST_XH_B4B-XH-A_1x04_P2.50mm_Vertical
J12: SLOT8_I2C; JST_XH_B4B-XH-A_1x04_P2.50mm_Vertical
J13: NEOPIXEL_OUT; JST_XH_B3B-XH-A_1x03_P2.50mm_Vertical
J14: SERVO_0; JST_XH_B3B-XH-A_1x03_P2.50mm_Vertical
J15: SERVO_1; JST_XH_B3B-XH-A_1x03_P2.50mm_Vertical
J16: SERVO_2; JST_XH_B3B-XH-A_1x03_P2.50mm_Vertical
J17: DFPlayer_L; PinSocket_1x08_P2.54mm_Vertical
J18: DFPlayer_R; PinSocket_1x08_P2.54mm_Vertical
J19: PCA9548A_0_L; PinSocket_1x12_P2.54mm_Vertical
J20: PCA9548A_0_R; PinSocket_1x12_P2.54mm_Vertical
J21: PCA9548A_1_L; PinSocket_1x12_P2.54mm_Vertical
J22: PCA9548A_1_R; PinSocket_1x12_P2.54mm_Vertical
J23: SPEAKER; TerminalBlock_TE_282834-2_1x02_P2.54mm_Horizontal
J24: CAPACITIVE; TerminalBlock_TE_282834-2_1x02_P2.54mm_Horizontal
J25: VIBRATION; TerminalBlock_TE_282834-2_1x02_P2.54mm_Horizontal
J26: EXTRA_PINS; PinHeader_1x09_P2.54mm_Vertical
Q1: Q_NMOS_GDS; TO-220-3_Vertical
R1, R2: 4.7K; R_Axial_DIN0207_L6.3mm_D2.5mm_P10.16mm_Horizontal
R3: 300; R_Axial_DIN0207_L6.3mm_D2.5mm_P10.16mm_Horizontal
R4: 1K; R_Axial_DIN0207_L6.3mm_D2.5mm_P10.16mm_Horizontal
R5: 10K; R_Axial_DIN0207_L6.3mm_D2.5mm_P10.16mm_Horizontal

Connections:
+3.3V: J3.15, J19.1, J19.5, J21.1, J21.5, J21.6, R1.1, R2.1
+5V: C1.1, D1.1 (K), J1.1, J2.15, J4.3, J5.3, J6.3, J7.3, J8.3, J9.3, J10.3, J11.3, J12.3, J13.1, J14.2, J15.2, J16.2, J17.1, J25.2
GND: C1.2, J1.2, J2.14, J3.14, J4.4, J5.4, J6.4, J7.4, J8.4, J9.4, J10.4, J11.4, J12.4, J13.2, J14.3, J15.3, J16.3, J17.7, J19.2, J19.6, J19.7, J19.8, J21.2, J21.7, J21.8, Q1.3 (S), R5.2
unnamed: D1.2 (A), J25.1, Q1.2 (D)
unnamed: J2.6, J26.4
unnamed: J2.7, J24.1
unnamed: J2.8, R4.1
unnamed: J2.9, Q1.1 (G), R5.1
unnamed: J2.10, J24.2
unnamed: J2.11, J26.3
unnamed: J2.12, J26.2
unnamed: J2.13, J26.1
unnamed: J3.7, R3.1
unnamed: J10.1, J19.12
unnamed: J10.2, J19.11
unnamed: J11.1, J19.10
unnamed: J11.2, J19.9
unnamed: J12.1, J21.10
unnamed: J12.2, J21.9
unnamed: J13.3, R3.2
unnamed: J3.11, J14.1
unnamed: J3.10, J15.1
unnamed: J3.9, J16.1
unnamed: J17.2, R4.2
unnamed: J17.6, J23.2
unnamed: J17.8, J23.1
unnamed: J3.5, J19.3, J21.3, R1.2
unnamed: J3.2, J19.4, J21.4, R2.2
unnamed: J4.1, J20.1
unnamed: J4.2, J20.2
unnamed: J5.1, J20.3
unnamed: J5.2, J20.4
unnamed: J6.1, J20.5
unnamed: J6.2, J20.6
unnamed: J7.1, J20.7
unnamed: J7.2, J20.8
unnamed: J9.1, J20.9
unnamed: J9.2, J20.10
unnamed: J8.1, J20.11
unnamed: J8.2, J20.12
unnamed: J3.13, J26.5
unnamed: J3.12, J26.6
unnamed: J3.8, J26.7
unnamed: J3.6, J26.8
unnamed: J3.1, J26.9

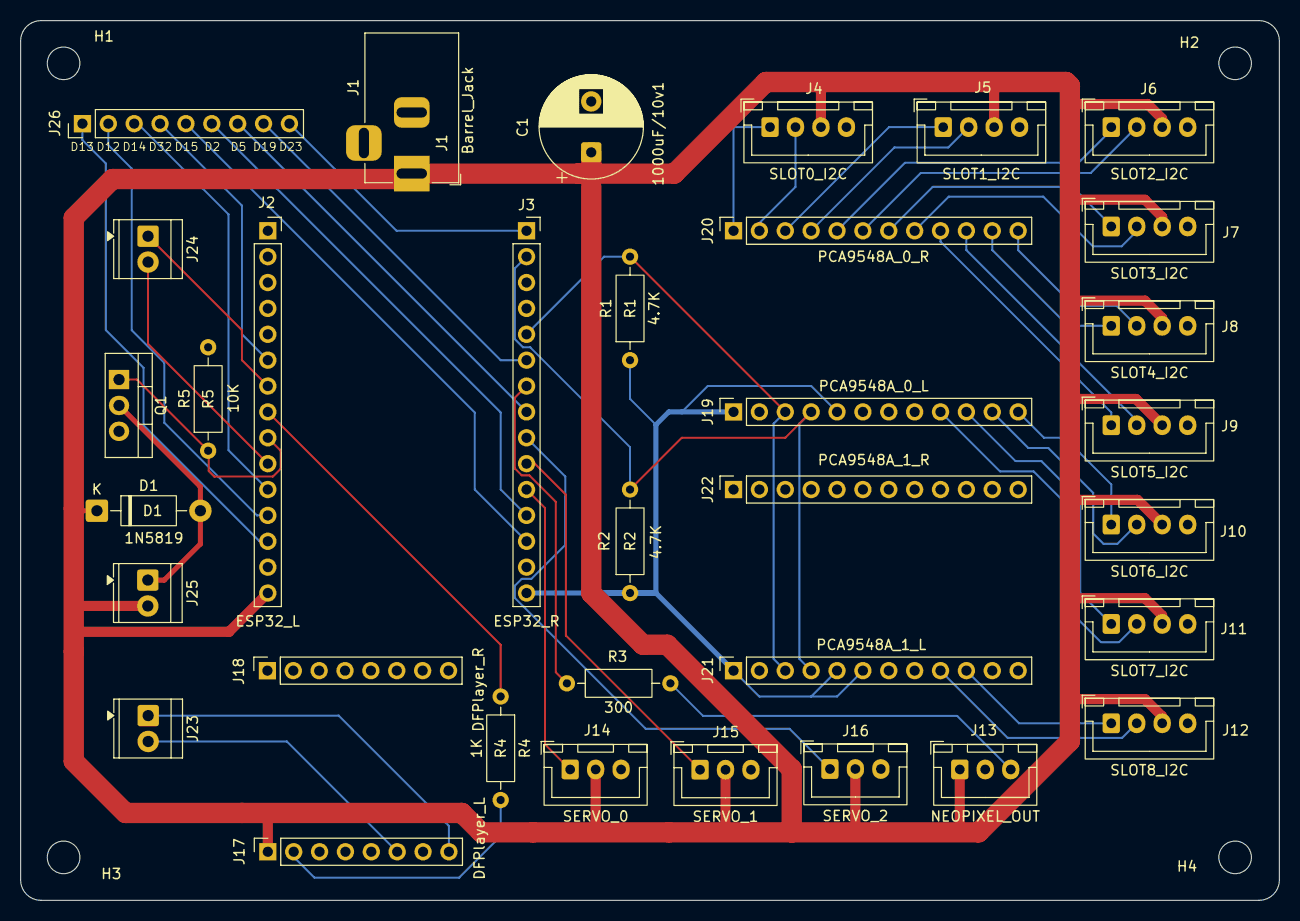
[picture p26: board motherboard.kicad_pcb from above]

Board: 2 copper layers, 123.6 x 86.4 mm, 38 parts (0 on the bottom side), 45 nets.
