mchirlin/camping-escape-room/05-technology-and-electronics/kicad/crafting-table/daughter-board/daughter-board.kicad_pcb

## KiCad design 05-technology-and-electronics/kicad/crafting-table/daughter-board/daughter-board.kicad_pcb (2026-08-13)

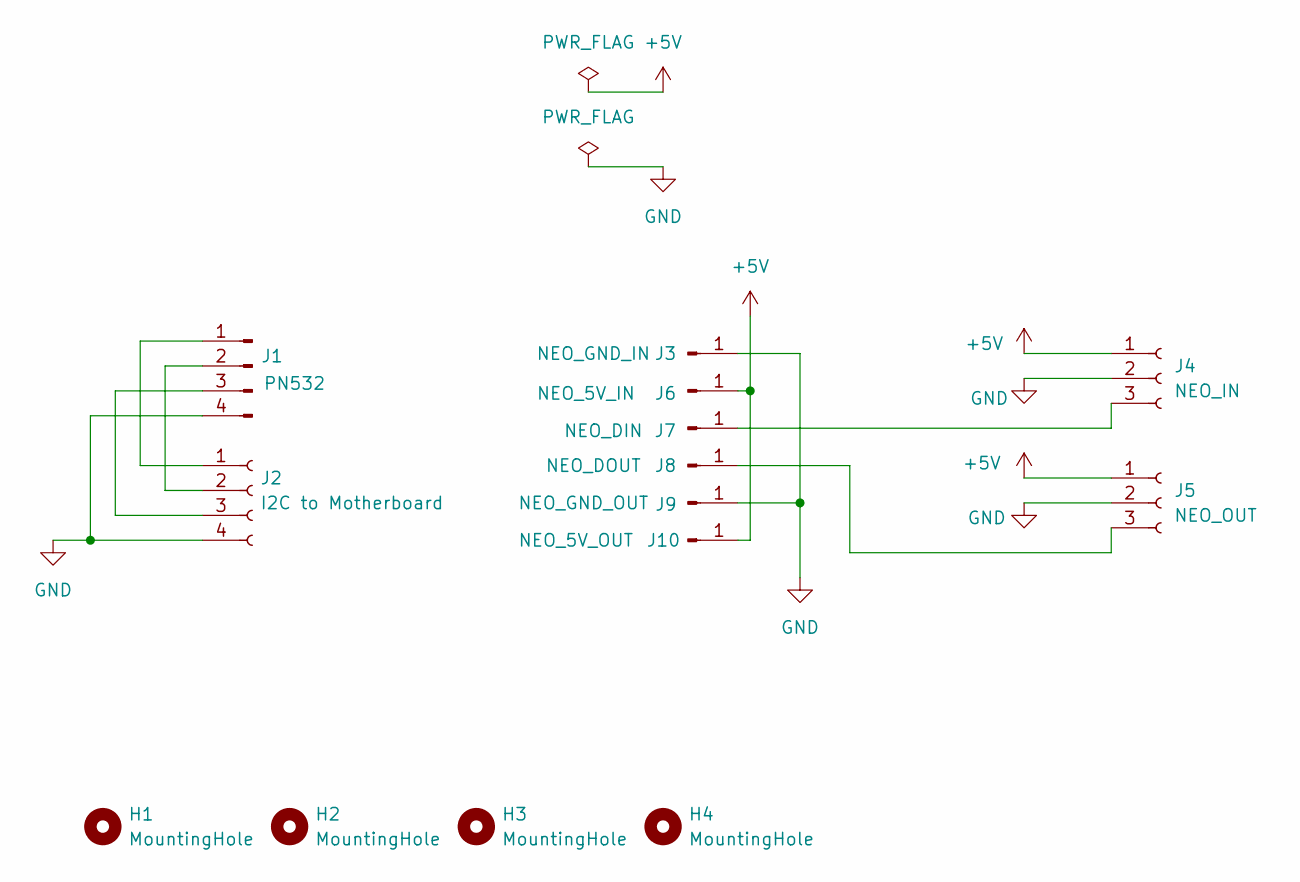
[picture p27: schematic daughter-board.kicad_sch]

Parts:
H1, H2, H3, H4: MountingHole; MountingHole_3.2mm_M3
J1: PN532; PinHeader_1x04_P2.54mm_Vertical
J2: I2C to Motherboard; JST_XH_B4B-XH-A_1x04_P2.50mm_Vertical
J3: NEO_GND_IN; PinHeader_1x01_P2.54mm_Vertical
J4: NEO_IN; JST_XH_B3B-XH-A_1x03_P2.50mm_Vertical
J5: NEO_OUT; JST_XH_B3B-XH-A_1x03_P2.50mm_Vertical
J6: NEO_5V_IN; PinHeader_1x01_P2.54mm_Vertical
J7: NEO_DIN; PinHeader_1x01_P2.54mm_Vertical
J8: NEO_DOUT; PinHeader_1x01_P2.54mm_Vertical
J9: NEO_GND_OUT; PinHeader_1x01_P2.54mm_Vertical
J10: NEO_5V_OUT; PinHeader_1x01_P2.54mm_Vertical

Connections:
+5V: J4.1, J5.1, J6.1 (Pin_1_1), J10.1 (Pin_1_1)
GND: J1.4, J2.4, J3.1 (Pin_1_1), J4.2, J5.2, J9.1 (Pin_1_1)
unnamed: J1.1, J2.1
unnamed: J1.2, J2.2
unnamed: J1.3, J2.3
unnamed: J4.3, J7.1 (Pin_1_1)
unnamed: J5.3, J8.1 (Pin_1_1)

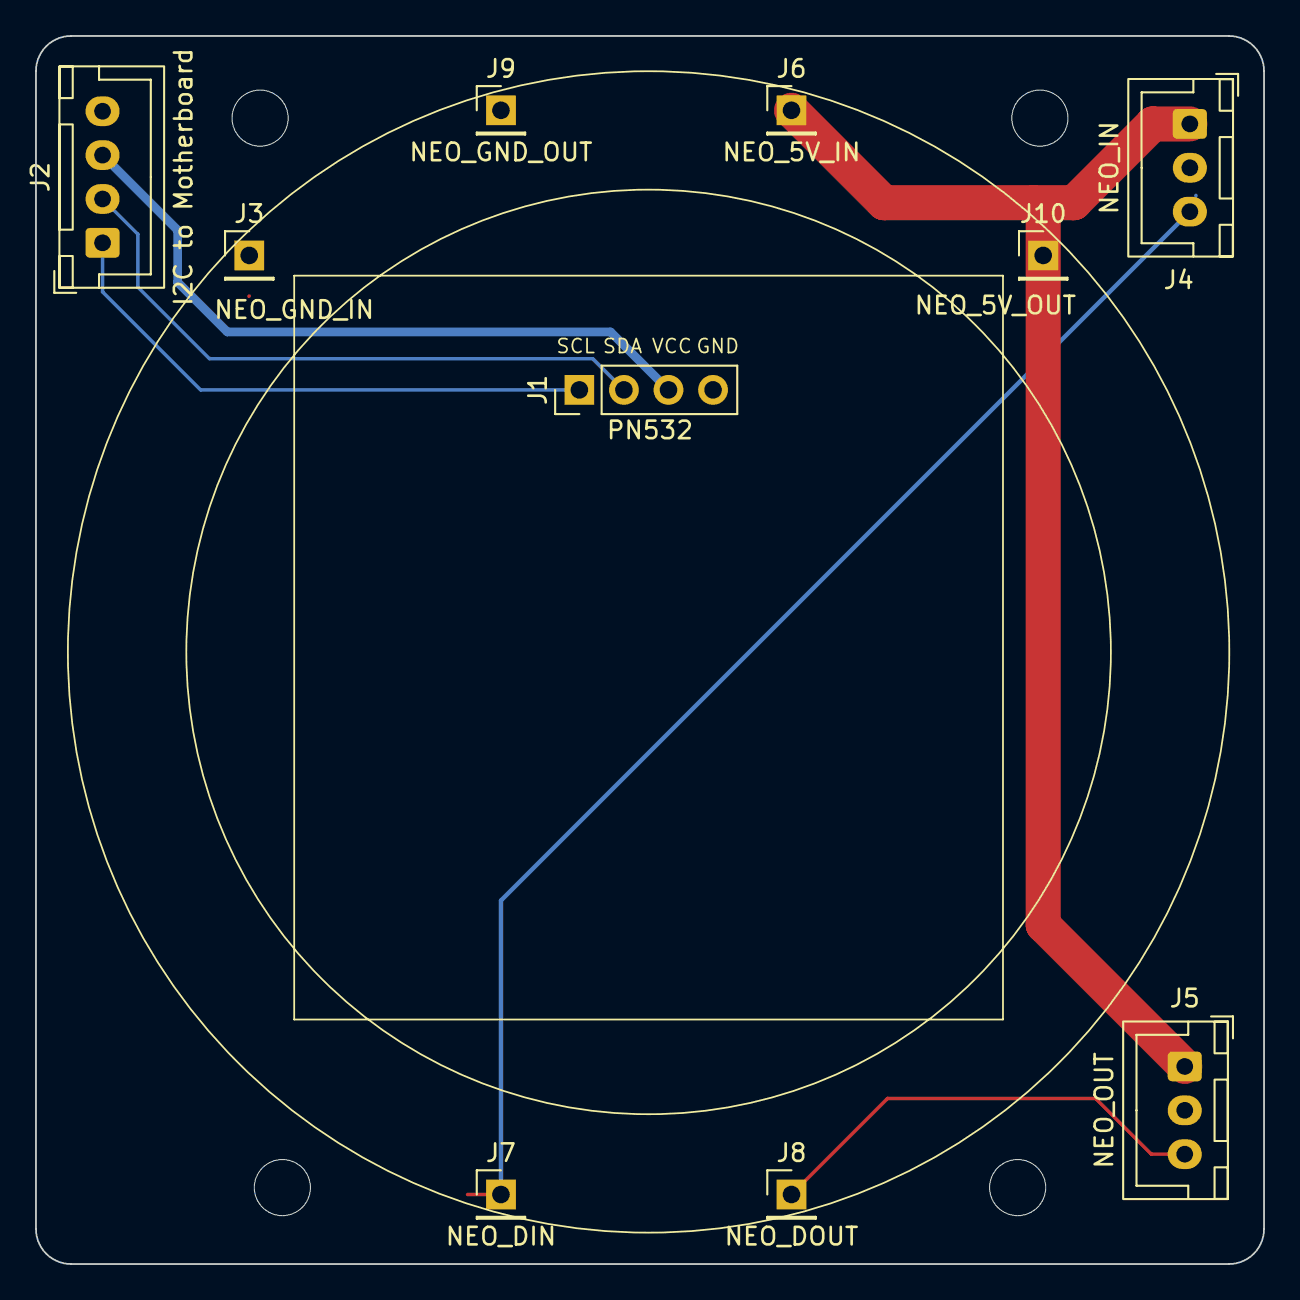
[picture p28: board daughter-board.kicad_pcb from above]

Board: 2 copper layers, 70.0 x 70.0 mm, 14 parts (0 on the bottom side), 7 nets.
