mchirlin/camping-escape-room/(commit log)

2026-04-26 Paper background, opaque fog, map border, compass heading, fullscreen button, marker collect
2026-04-26 Fix: paper background, no fog drawing, torn border frame with black outside
2026-04-26 Fix rendering order: black bg → paper texture → terrain on top
2026-04-26 Map rotation, WASD heading, quadrant discovery, forest/park terrain, reveal all
    - Fix map background rotating with terrain tiles
    - WASD movement now relative to heading direction
    - Map quadrants appear as player discovers them
    - Add forest from OSM multipolygon relations (join open ring segments)
    - Add park terrain for campsites (lighter green clearings)
    - Add sports fields as sand terrain
    - Add Reveal All button (reveals fog + discovers all quadrants)
    - Default map level set to 0
    - Regenerate Lake Fairfax terrain data with all fixes
2026-04-26 Add multi-region support with 2632 Depaul Dr location
    - Generate terrain data for Depaul Dr area
    - Split terrain into per-region files (terrain-lakefairfax.json, terrain-depaul.json)
    - Add regions.json index for available map regions
    - Add region selector dropdown in simulation UI
    - Region selection via ?region=<id> URL parameter
    - Switching regions reloads with the new region param
2026-04-26 Make Reveal All button always visible (not just simulation mode)
2026-04-26 Fix fullscreen button on mobile, revert reveal all visibility
2026-04-26 Add Remove All Items button to clear all placed markers
2026-04-26 Add confirmation dialog to Reveal All button
2026-04-26 Update escape room plan: integrate fog map + compass into game flow
    - Maps (1-2 devices) unlocked by crafting Map recipe #4
    - MCompass points to tent/crafting table (home base), not dig site
    - Updated TODO with completed fog map tasks
    - Updated game day setup, reset, and pack checklist
2026-04-26 Remove hand-drawn treasure map — dig site is now a marker on the fog map
2026-04-27 Only auto-center on player in orientation mode, allow free panning in north-up mode
    [Crafting table.skp, Crafting table~.skp]
2026-04-27 Add crafting table materials list to TODO
2026-04-27 Add servo door section to TODO: 3 doors, servos, driver, mounts, firmware
    [Crafting table.skp, Crafting table~.skp]
2026-04-27 Update servo doors: gravity latch design with reed switch auto-close
2026-04-27 Detail servo door design: hidden servos, slot latch, flush doors, full build steps
2026-04-27 Update TODO and SHOPPING-LIST with all materials: table lumber, servo doors, TNT chest, new block counts
2026-04-27 Add plywood wooden props to ordering and timeline (sword, pickaxe, shovel, rod)
2026-04-27 Remove PCA9685 — drive 3 servos directly from ESP32 GPIO pins
2026-04-28 Redesign doors: servo push-open + ball catch, piano hinges, remove reed switches
    [Crafting table.skp, Crafting table~.skp, MiniServoBracket_v2.stl]
2026-04-28 fix: move MAP_LEVEL_CONFIG declaration before first usage
    Resolves ReferenceError caused by temporal dead zone — the const was
    declared after the loop that referenced it.
2026-04-28 fix: update test assertions and show sim hints on toggle
    - Adjust fog-engine property test to use strict radius boundary check
    - Update map-interaction zoom clamp expectations to match new limits
    - Show/hide simHints element alongside simBanner in UI overlay
2026-04-28 Fix all 7 failing tests: zoom clamps, UI overlay hints/compass, fog engine boundary tolerance
    - Update zoom clamp tests to match actual MIN_ZOOM=-3, MAX_ZOOM=6
    - Restore createSimulationHints() call in init
    - Toggle simHints visibility in setSimulationVisible
    - Set initial compass arrow transform to rotate(0deg)
    - Fix fog engine property test: add 1m tolerance and bbox bounds check for square grid edge tiles
2026-04-30 fog map: auto-select closest region via GPS, add simulation exit button
2026-05-02 Update stencils, add generator script and 3D block model
    [minecraft-block.scad]
2026-05-02 Add PCB designs, Arduino sketches, and electronics documentation
    [daughter-board.kicad_pcb, motherboard.kicad_pcb, motherboard.kicad_sch]
2026-08-16 Add recipe matching, WiFi web UI, tag registration, map markers, 3D models
    - Crafting table firmware: recipe matching with 3s touch-hold, rainbow/red
    animations, door servo mapping, game reset, block-type-colored LEDs
    - Interactive test: WiFi AP web control, tag write-to-NFC, touch sensors,
    servo/motor web controls, responsive RFID scanning
    - Map: added missing marker icons (redstone, gunpowder, sand, coal,
    copper_ingot, amethyst_shard, paper, tnt_chest), updated MarkerTag type
    - 3D models: gold_ingot, gunpowder, coal, copper_ingot, amethyst_shard,
    paper item SCADs; paint stencils; block cube model (2.5" hollow chamfered)
    - Stickers: block face sheets (oak_planks, sand), combo extras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
    [1 pixel stencil.stl, 1 pixel.stl, 2 pixel stencil.stl, 2 pixel.stl, 3 pixel.stl, amethyst_shard-item.scad, amethyst_shard-item.stl, bambu-project.3mf]
2026-08-16 Add recipes, block types, sounds, cobblestone, tripwire_hook
    - Firmware: 13 recipes (added torch, map, spyglass, diamond pickaxe,
    iron sword, crossbow, stone pickaxe), sound uses flat mp3/ tracks,
    cobblestone + tripwire_hook block types, recipes web display
    - Sounds: extracted 5 new MP3s from Minecraft assets (crossbow, door
    open/close, enchant, pling), updated SD card README
    - Map: added cobblestone marker type + icon
    - Models: tripwire_hook SCAD + sticker, cobblestone block stickers
    - Steering: added adding-block-types-and-recipes.md guide
    - TODO: updated with pending print/program/test items
    [tripwire_hook-item.scad]
2026-08-16 Firmware: 2s touch ramp-up, volume slider, texture-accurate colors, re-encoded audio
    - Touch: 2s hold with PWM vibration ramp-up (30→255), toast_in sound on start
    - Web UI: volume slider, reordered layout (register tags at bottom, game state
    near recipes)
    - LED colors: computed from average pixel color of each Minecraft texture
    - Audio: all 20 MP3s re-encoded to 44.1kHz mono 128kbps (fixes DFPlayer pitch)
    - Volume default set to 30/30 (max)
    [crafting-table-firmware.ino]
2026-08-16 Add background music, 3s exponential vibration ramp, music web controls
    - Background music: plays sweden.ogg (track 21) on loop at startup
    - Web UI: Music ON/OFF buttons in volume section
    - Touch ramp: back to 3s, exponential curve (progress²), starts at duty 50
    for immediate motor spin, ~300 smooth steps to max
    - Added 0021_sweden.mp3 to SD card folder
    [crafting-table-firmware.ino]
2026-08-16 Switch to folder-based DFPlayer, add 28 effects + 10 music tracks
    - DFPlayer: switched from /mp3/ flat to folder-based (01/, 02/, 03/)
    - Firmware: uses dfPlayer.playFolder() for reliable track targeting
    - Folder 01: block_place click
    - Folder 02: 28 sound effects (craft, mobs, UI, explosions, food, doors)
    - Folder 03: 10 background music tracks (sweden, wet_hands, haggstrom, etc.)
    - All audio: 44.1kHz mono 128kbps for DFPlayer compatibility
    - TODO: added compass to items list
2026-08-16 NDEF tag format, NFC scan-to-map, tabbed web UI, motor fixes
    - Tags: switched to NDEF URI format (iPhone + ESP32 compatible)
    URL: https://mchirlin.github.io/camping-escape-room/?scan=TYPE
    - Map: added ?scan= handler — first scan places marker at GPS,
    second scan near same spot collects it (removes marker)
    - Web UI: reorganized into 3 tabs (Game / Admin / Test),
    added motor PWM slider for testing
    - Motor: removed PWM ramp-up (caused whine), uses full digitalWrite
    during 3s hold instead
    - Volume: default 25/30
    [crafting-table-firmware.ino]
2026-08-16 Add Firebase Firestore for real-time marker sync across devices
    - Replaced REST polling marker-db with Firebase Firestore
    - Real-time onSnapshot listener — markers sync instantly across phones
    - Falls back to localStorage if Firebase unavailable
    - All sounds re-organized into DFPlayer folders (01/02/03)
2026-08-16 Fix NDEF URL length bug, tabbed web UI, block model update
    - Fixed TAG_URL_BASE_LEN (was 46, should be 45) — null byte was breaking
    iPhone NDEF auto-detect and ESP32 verify read-back
    - CC write: attempt in registration, log success/failure
    - readTypeFromTag: reads pages 17-20 only, finds first lowercase char
    - Block model: increased chamfer factor to 0.98 for larger tag cavity
    - TODO: updated SD card copy status
    [minecraft-block.scad, minecraft-block.stl]
2026-08-16 Logical block type ordering, emerald type, signs, block model, TODO updates
    - Block types reordered everywhere: Blocks > Ingots > Gems > Materials
    - Added emerald as block type (firmware, map, marker icon)
    - Firmware: registration dropdown grouped with category headers
    - Map: MarkerTag and MARKER_TAGS reordered with comments
    - Steering doc: added canonical ordering reference
    - Block model: redesigned as hollow cube with tag pocket at bottom
    - Signs: abandoned mine + fishing hole with Minecraft font
    - TODO: updated counts (11 cubes, power wired, paper printed)
    [emerald-item.scad, emerald-item.stl, minecraft-block.scad, minecraft-block.stl, tripwire_hook-item.stl]
2026-08-16 Map: inventory slot marker style, collect proximity check, collect handler
    - Markers now display in Minecraft inventory slot frame (gray bg, beveled border)
    - Collect button requires GPS within 15m of marker
    - Added collect-marker event listener for real map view
    - Shows distance toast if too far away
2026-08-17 Add inventory slot background to Minecraft canvas view markers
2026-08-17 Fix canvas marker: preserve aspect ratio, consistent slot rendering
2026-08-17 UID-based marker matching: unique tag identity for collect/place
    - ESP32: NDEF URL now includes &uid=XXXX (tag's unique hardware ID)
    - Map: stores uid per marker in localStorage + Firebase
    - Scan with UID: first scan places marker with that uid, second scan
    collects the exact marker matching that uid (not just nearest by type)
    - Fallback: tags without uid still use proximity matching
    - Prevents collecting wrong marker when same block type is nearby
    [crafting-table-firmware.ino]
2026-08-18 Add compass block type, fix Map recipe, add Farrok's house region, print sheets, tripwire fix
    [bambu-project.3mf, tripwire_hook-item.scad, tripwire_hook-item.stl]
2026-08-18 Rename Depaul region to Michael's House, add terrain generation steering file
2026-08-19 Add avatar picker with all 9 Minecraft skins (Steve, Alex, Ari, Efe, Kai, Makena, Noor, Sunny, Zuri)
    [bambu-project.3mf]
2026-08-23 Session updates: firmware recipe overhaul, admin map mode, recipe cards
    Firmware:
    - Remove non-storyline recipes (Wooden Pickaxe, Diamond Shovel, Gold Sword, Bow, Crossbow)
    - Reorder recipes to storyline order (9 recipes + Crafting Table with 4 variants)
    - Add craftGroup system for multi-pattern recipes sharing crafted state
    - Swap servo 0/2 pin assignments, update door mappings
    - Add Steve figurine jukebox mode (cycles through 10 Minecraft tracks)
    - Add emerald and steve as programmable block types
    - Fix readTypeFromTag parsing (stop at '&' character)
    - Saturate NeoPixel block colors for better visibility
    - Update volume default to 30, craft hold to 2 seconds
    - Add track selection UI with f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
    [bambu-project.3mf, paver-angle-shim.scad]
2026-08-23 Map: multiplayer avatars, admin marker visibility, remove fullscreen
    - Add multiplayer player tracking via Firebase 'players' collection
    - Non-admin devices broadcast position + avatar every 3s
    - Other players' avatars render on the map in real-time (28px)
    - Players auto-expire after 30 min of no updates
    - Admin mode: hidden markers show at 40% opacity with red X overlay
    - Admin mode: tap marker to reveal/hide individually via popup
    - Admin mode: skip fog check for marker click detection
    - Remove fullscreen button from UI
    - Fix pre-existing 'size' variable bug in count badge rendering
2026-08-23 Props, signs, map fixes, recipe card tweaks
    Props:
    - Generate all 6 lock-out signs (explorer tent, mine, quarry, cave, creeper, treasure)
    - Signs rotated 90° for portrait printing, auto-scaled text
    - TNT sticker sheet (4 sides + 1 top, matching block sticker style)
    - Minecraft map iPhone 15 Pro case (pixelated border from filled_map.png texture)
    Recipe cards:
    - Lighter slot background for better item contrast
    - Postcard size (148x100mm) for Selphy printing
    - Font size 22 for title
    Map app:
    - Rename marker tags to match firmware (wood_plank, iron_ingot, gold_ingot)
    - Remove NFC-to-marker mapping (names are now consistent)
    - Player stale timeout reduced to 10 seconds
    - Add pagehide/visibili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
    [bambu-project.3mf, minecraft-map-case-iphone15pro.scad, minecraft-map-case-iphone15pro.stl, minecraft-map-case-iphone5s.stl]
2026-08-24 Add journal pages (sand bg, pixel corners), trade card, firmware/fog-map/flowchart updates
    - Journal: 12 pages with Minecraft sand texture bg, pixel-rounded cut corners,
    dark frame, compass TODO removed (blank space for handwriting)
    - Trade card: villager emerald→bag card in recipe-card style
    - Firmware: various recipe/block/servo updates
    - Fog map: markers always visible, admin mode, multiplayer avatars
    - Flowchart: updated game flow with inventory tracking
    - TODO: updated checklist
    - iPhone case: parameter tweaks
    [minecraft-map-case-iphone15pro.scad]
2026-08-24 Map case: rectangular shape from map_background.png, fix camera side, add button hollows, top bezel
    - Redesign case outline from diamond to rectangular using Minecraft map_background.png texture
    - Fix camera cutout to correct side, enlarge for both iPhone 15 Pro and 16 Pro
    - Add side button hollows (left: volume/action/camera control, right: power)
    - Add 18mm top bezel to hide status bar/Dynamic Island
    - Shift phone pocket so visible screen is centered in map shape
    - Use separate pixel_x/pixel_y for even border with wider sides
    Fog map app:
    - Remove zoom +/- buttons from UI overlay
    - Change background from black to parchment brown (#c6a264)
    - Prevent scrolling past map edge (viewport-aware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
    [minecraft-map-case-iphone15pro.scad]
2026-08-24 Map case: uniform 3mm lip all sides; fog map: use inner parchment color, remove map border texture
    [minecraft-map-case-iphone15pro.scad]
2026-08-25 Shared fog of war via Firebase, TNT fuse+explosion sound/lights, firmware fixes
    Fog map:
    - Add fog-sync.ts for Firebase Firestore shared fog state
    - FogEngine now pushes reveals to Firebase and listens for remote updates
    - All players share the same fog — real-time multiplayer reveal
    - localStorage still used as local fallback
    - Fix explosion sound: was playing wrong track (005=xp_pickup), now uses 006
    - Skip block placement sound for gold_ingot and tnt (prevents DFPlayer collision)
    - New TNT animation: fuse spark travels ring-to-ring (2.8s) then explosion flash
    - Synced to combined fuse+explosion audio file
    Sounds:
    - Add tnt_fuse.ogg (extracted from Minecraft random/fuse.ogg)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
    [crafting-table-firmware.ino]
2026-08-25 Location markers: distinct pin style + required-item icons; TNT fuse animation
    - Add 6 new location marker types (waypoint, villager, stream, quarry, cave, spyglass_hill)
    - All 10 flowchart locations now placeable on the map
    - Location markers render with distinct larger colored pin style vs item slots
    - Each location uses the icon of the item needed to enter/use it:
    stream=fishing rod, cave=torch, villager=emerald, waypoint=compass,
    mine=stone pickaxe, quarry=diamond pickaxe, creeper=creeper
    - Pin frame colors themed to match each icon
    - TNT fuse animation: burns through rings in order 8-7-6-5-0-1-2-3-4
    - Fuse spark uses TNT red color, rings go dark as fuse burns pas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
    [crafting-table-firmware.ino]
2026-08-25 Location markers: treasure chest icon, remove dig_site, no collect on locations, name labels, admin delete
    - Treasure Chest marker now uses actual chest icon (was TNT texture), gold pin
    - Remove unused dig_site marker tag and texture
    - Locations can no longer be collected (Collect hidden in both canvas & Leaflet popups)
    - Location names rendered in Minecraft (Press Start 2P) font next to each pin
    - Admin Delete button on canvas marker popup — the way to remove locations
2026-08-25 Fog map: render remote-revealed fog, allow zoom-out to fit whole region
    - Shared fog: remote reveals now mark their quadrants discovered so fog
    cleared by other players actually renders (fixes invisible shared fog)
    - Add fogEngine.onRemoteReveal callback wired to quadrant discovery in main
    - Dynamic min zoom: can now zoom out far enough to fit the entire region
    (with margin showing area beyond the region edges)
    - Update map-interaction tests for viewport-aware clamp and dynamic min zoom
2026-08-25 Add onboarding overlay: avatar/name pickers + how-to, persisted in Firestore
    - New onboarding.ts: welcome overlay with character picker, name input, and a
    short how-to (walk to uncover, item vs location marker examples, tap to collect)
    - Shows on first load for non-admin players; blocks map until they Start
    - Onboarding state persisted as players/{id}.onboardedAt in Firestore so it
    survives sessions and works cross-device
    - Player docs no longer deleted on leave (marked stale via updatedAt:0) so the
    onboarding flag persists; avatar still hides via staleness filter
    - Admin 'Reset Intro' button clears onboardedAt for all players (re-onboard everyone)
    - Onboarding avatar/name sync to the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
2026-08-25 Fog map: reveal-on-fog markers + clearer admin marker states
    - Add revealOnFog marker flag: items stay invisible to players until the fog
    over their tile is uncovered (threaded through MarkerStore, DbMarker, Firebase)
    - Admin Add Item popup: 'Only show when uncovered' checkbox to place them
    - Render/click gating: fog-gated markers hidden from players until uncovered,
    then auto-appear; admins always see them
    - Replace red-X hidden indicator with corner emoji badges: 🙈 manually hidden,
    🌫️ reveal-on-fog pending; popup shows status text
    - Onboarding: add 'Work together with your friends to uncover the map' line
2026-08-25 Onboarding tweaks + center on player on first GPS fix
    - Onboarding how-to: combine 'work together' into the walk line, reorder to
    items > tap > locations, add 'Visit locations to move forward on your quest',
    align all icons in fixed-width centered cells
    - Map now centers on the player on the first GPS fix (falls back to clamped
    nearest point if outside region); afterward only auto-follows in heading mode
2026-08-25 Add finale songs and region-scope map markers
    - Add three end-of-event songs (victory, event, campfire) in Suno format
    - Scope fog-map markers to their region (regionId + bbox fallback for legacy markers)
    - Persist revealOnFog to Firestore
    - Update project notes, journal pages, cohost briefing, and props artifacts
    [bambu-project.3mf, minecraft-map-case-iphone15pro.stl]
2026-08-26 Two-state recipes with per-recipe lock/unlock/force-craft + dev preview
    - Firmware: collapse recipe state to LOCKED/UNLOCKED (drop COMPLETED); a
    craft now returns the recipe to LOCKED. /status reports recipeStates,
    /recipestate accepts locked|unlocked, new /craft?r=N force-fires a recipe
    (door + sound + lights), /recipes includes raw index
    - Web UI: remove Game State section; each recipe card shows a state badge
    and Lock/Unlock/Craft actions; recipes grid spans full width; move Motors
    to the Test tab and Music to the Admin tab
    - Add standalone dev-preview.html with an in-browser mock backend to demo
    the control panel without the ESP32
2026-08-26 Sequenced background music, sound reassignments, and door remap
    Sound:
    - Craft-complete now plays the old gold fanfare (02/004); gold_ingot cycles
    folder 04 tracks 001/003; dragon_egg plays folder 04 track 002 (no cycle)
    - Background music plays as a sequenced playlist (auto-advances track to track,
    wraps 010->001) instead of looping one track; resumes on its own after 15s
    of silence; Steve jumps to the next track
    - Remove the now-unused Play/Stop music buttons from the web UI
    Doors (2-0-1 sequence): Cobblestone Pickaxe -> door 0, Map -> door 1 (+ iPad).
    Map recipe card now found openly in the Old Mine, not behind a door.
    Update flowchart.md (source of truth), dev-preview mock, and S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
2026-08-26 Reorganize sounds/narrative, celebration-song fix, remove quadrant discovery
    File reorganization:
    - Move sounds/ and narrative docs (campfire-song, event-song, explorers-diary)
    into 06-sound-lighting-atmosphere/
    - Add speaker-hole-pattern (html/pdf/svg)
    - Update bambu-project, TIMELINE
    Firmware (crafting-table-firmware.ino):
    - Fix celebration songs (gold/dragon) being cut off at 15s by the idle timer:
    add celebrationPlaying flag so long songs play to completion uninterrupted;
    idle restart begins only after the song finishes
    - All short effects (click, craft, error, toast, TNT) explicitly clear the
    celebration flag to prevent stuck state
    Fog-of-war map:
    - Remove quadrant discovery s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
    [bambu-project.3mf]
2026-08-27 Door compartment lights + timer-based music advance
    Door LEDs (24 total, 8 per door, chained after the 9 grid rings):
    - On a craft, light only that recipe's door in the produced item's color with
    a playful chase + sparkle + steady glow (Recipe gains a color field)
    - Auto-off each door light 30s after it lights (non-blocking per-door timer)
    - Grid animations (rainbow/victory/dragon/explosion) now paint only the ring
    LEDs, so unrelated doors no longer light up during a craft
    - Test tab: Door 0/1/2 test buttons + Door Lights Off (dr0/dr1/dr2/droff)
    Background music:
    - Fix songs never advancing (stuck on track 1): the DFPlayer is wired TX-only
    so the 'track finished' event can't be receiv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
    [crafting-table-firmware.ino]
2026-08-28 Fog-map admin reset controls, firmware/docs updates
    - Fog map: collapsible admin panel with Reset Run (players+fog+intro,
    keeps items) and Reset Game (full wipe incl. items); add
    deleteAllPlayers/deleteAllFog/fogEngine.clearLocal
    - NOTES: correct crafting-table state persistence (survives power cycle)
    - TODO: fix recipe count/names to match 10-craft flowchart
    - Add final testing checklist
    - Firmware + Bambu project updates
    [bambu-project.3mf]
